rushabhcodes/desk-fidget-counter/__snapshots__/index.circuit-3d.snap.png

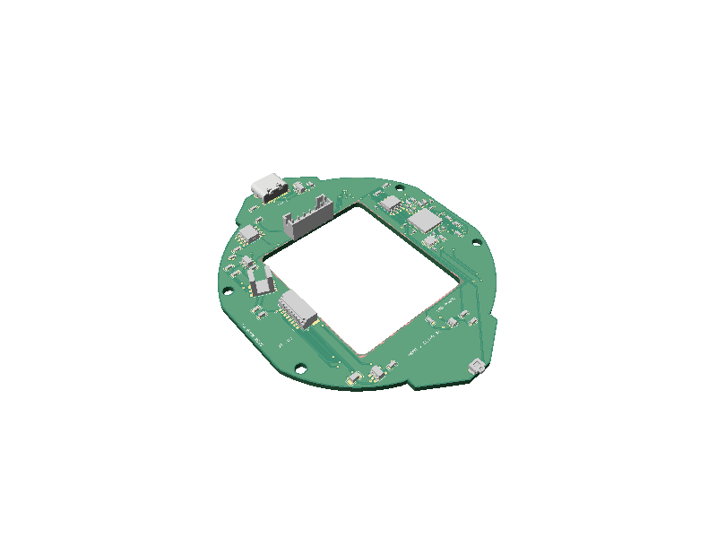
__snapshots__/index.circuit-3d.snap.png
