rushabhcodes/desk-fidget-counter/dist/index/pcb.png

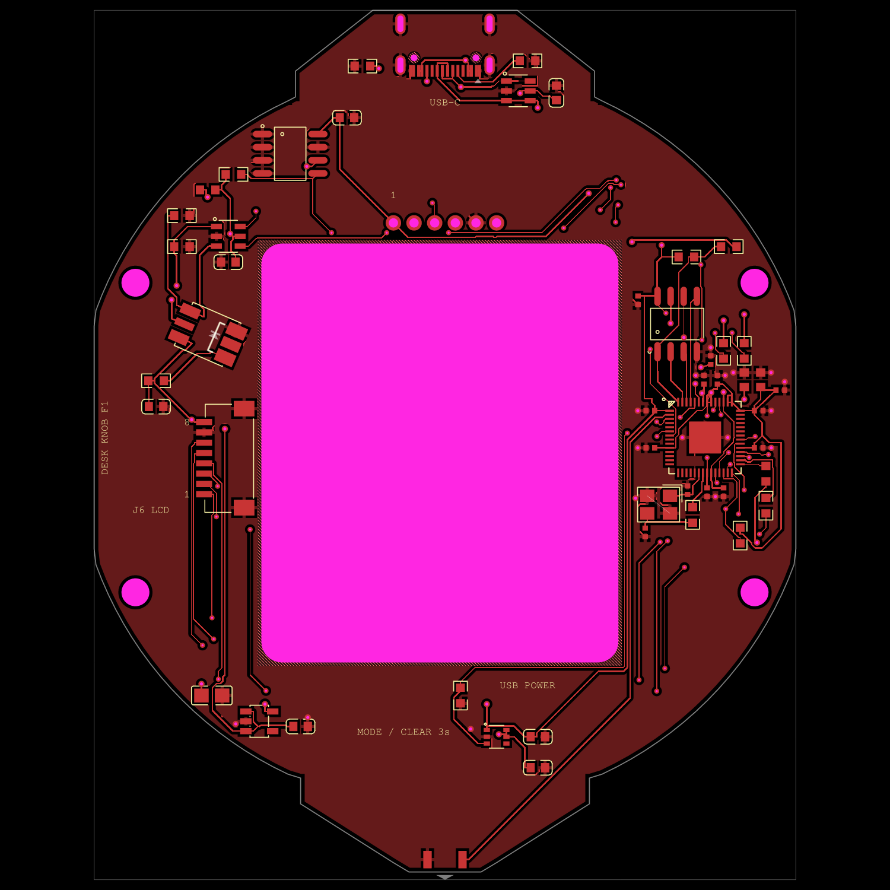
dist/index/pcb.png
