rushabhcodes/desk-fidget-counter/dist/index/schematic.png

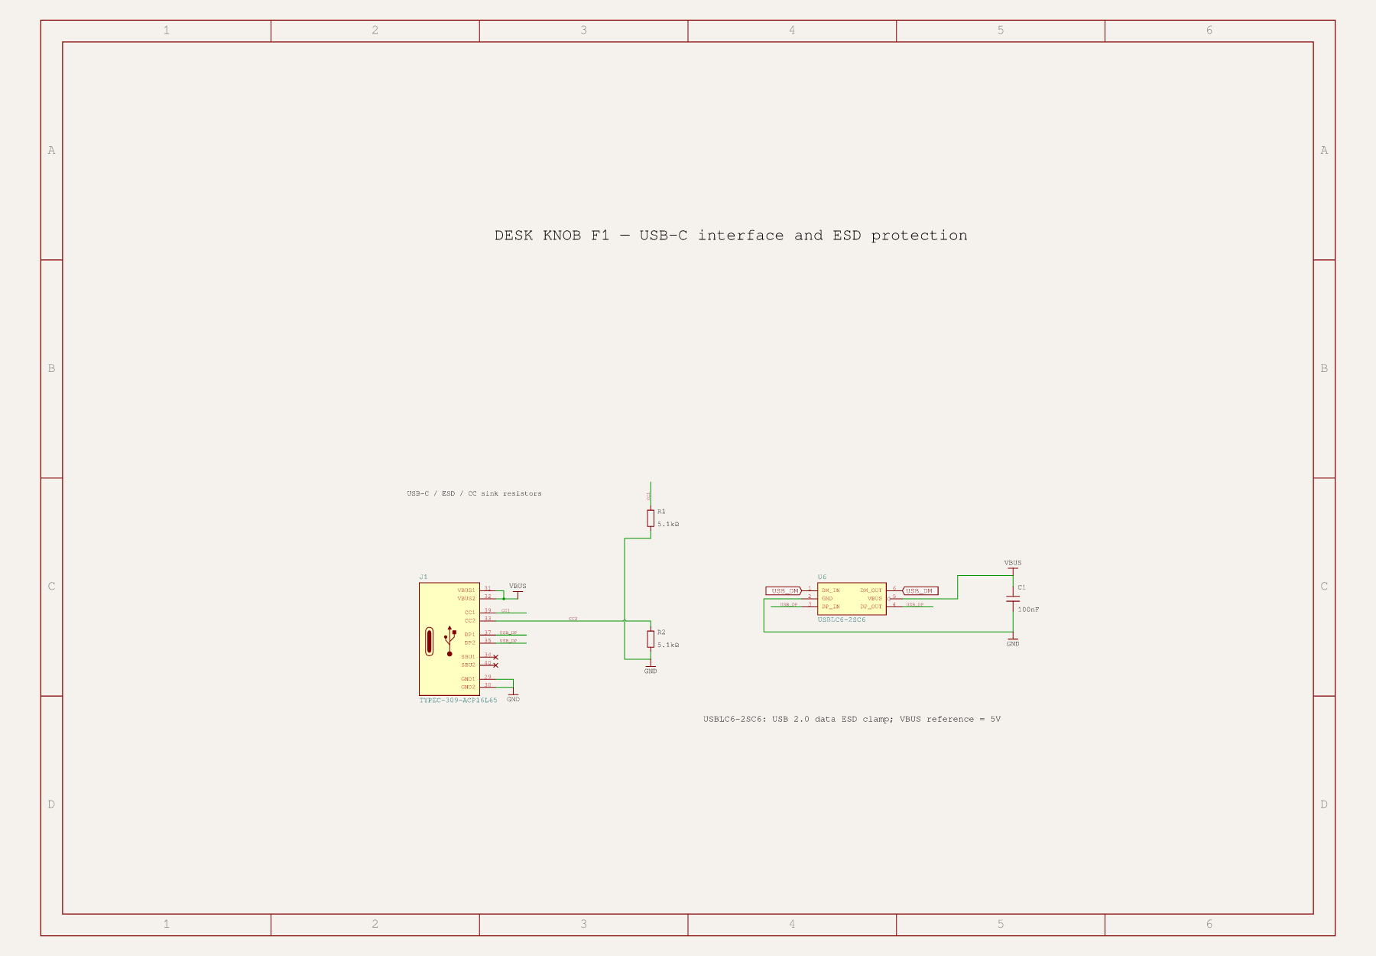
dist/index/schematic.png
