rushabhcodes/desk-fidget-counter/manufacturing/current/assembly/schematic-2-usb-power-and-switched-peripherals.png

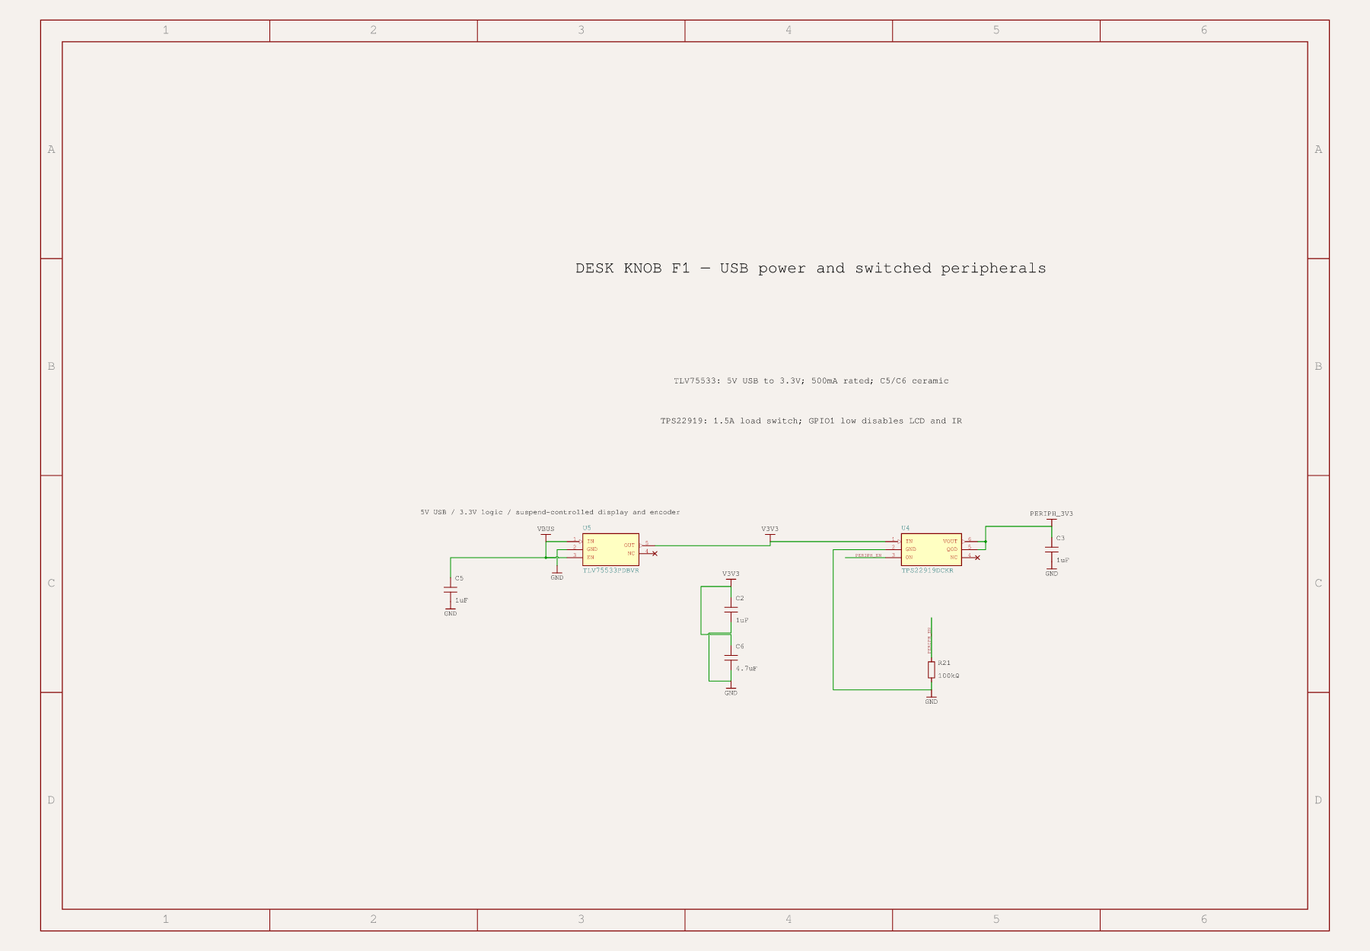
manufacturing/current/assembly/schematic-2-usb-power-and-switched-peripherals.png
