rushabhcodes/desk-fidget-counter/manufacturing/current/assembly/schematic-3-rp2040-power-controls-and-programming.png

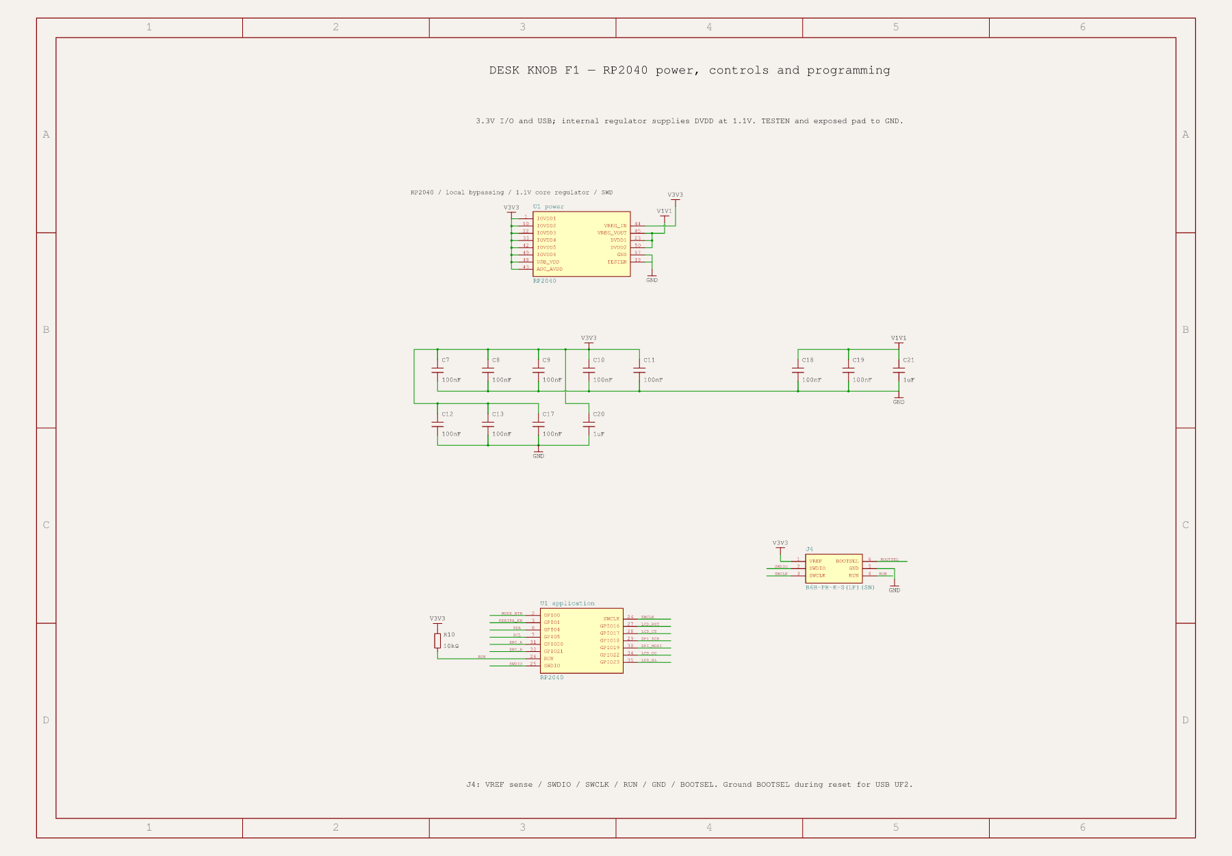
manufacturing/current/assembly/schematic-3-rp2040-power-controls-and-programming.png
