rushabhcodes/desk-fidget-counter/manufacturing/current/assembly/schematic-4-optical-rotation-encoder.png

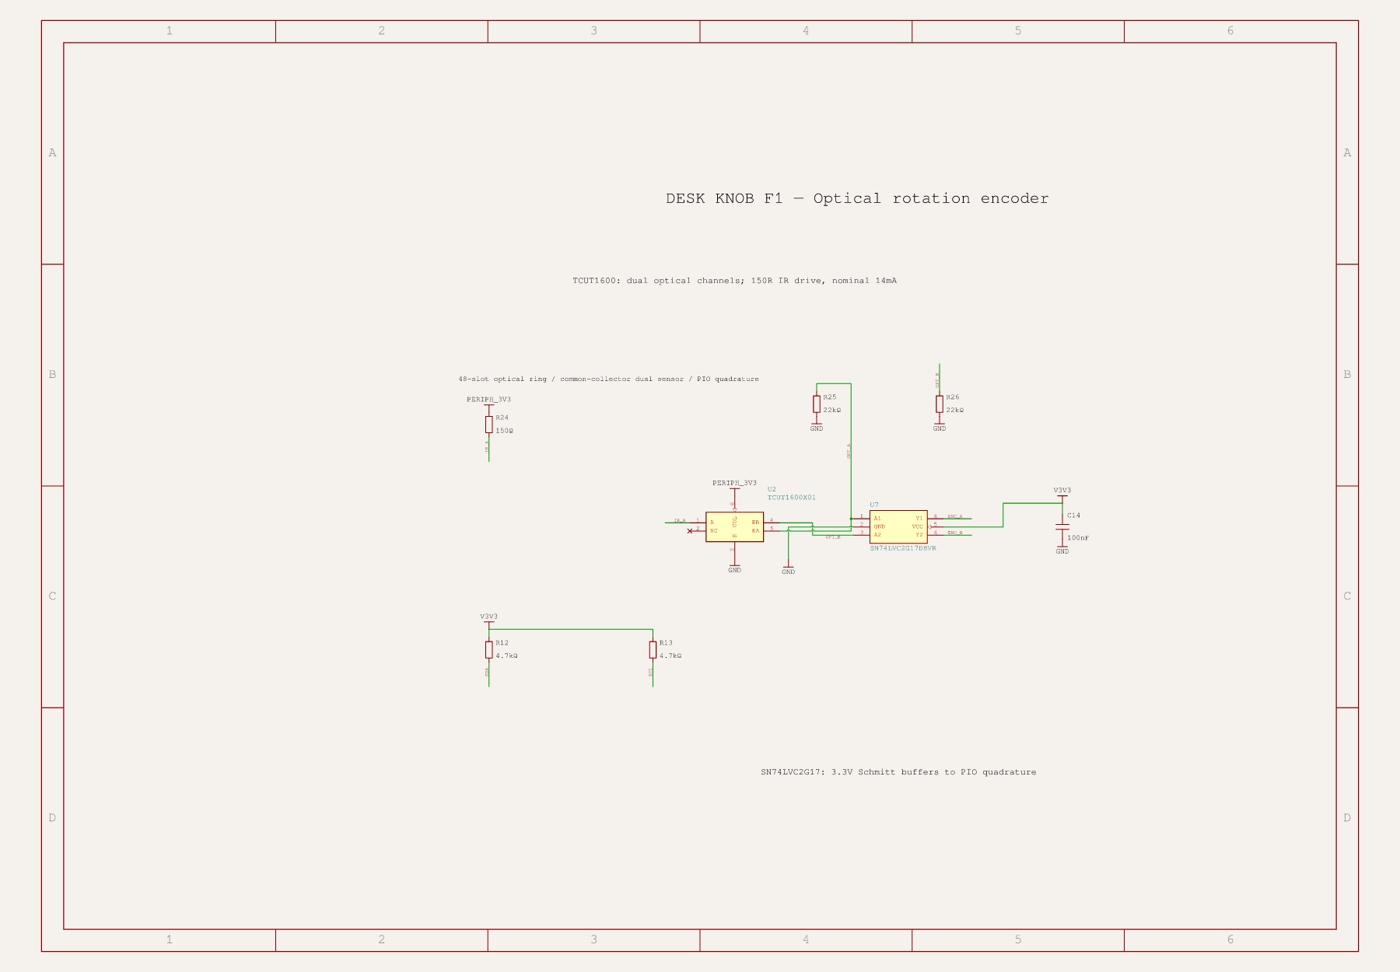
manufacturing/current/assembly/schematic-4-optical-rotation-encoder.png
