rushabhcodes/desk-fidget-counter/manufacturing/current/assembly/schematic-5-persistent-turn-storage.png

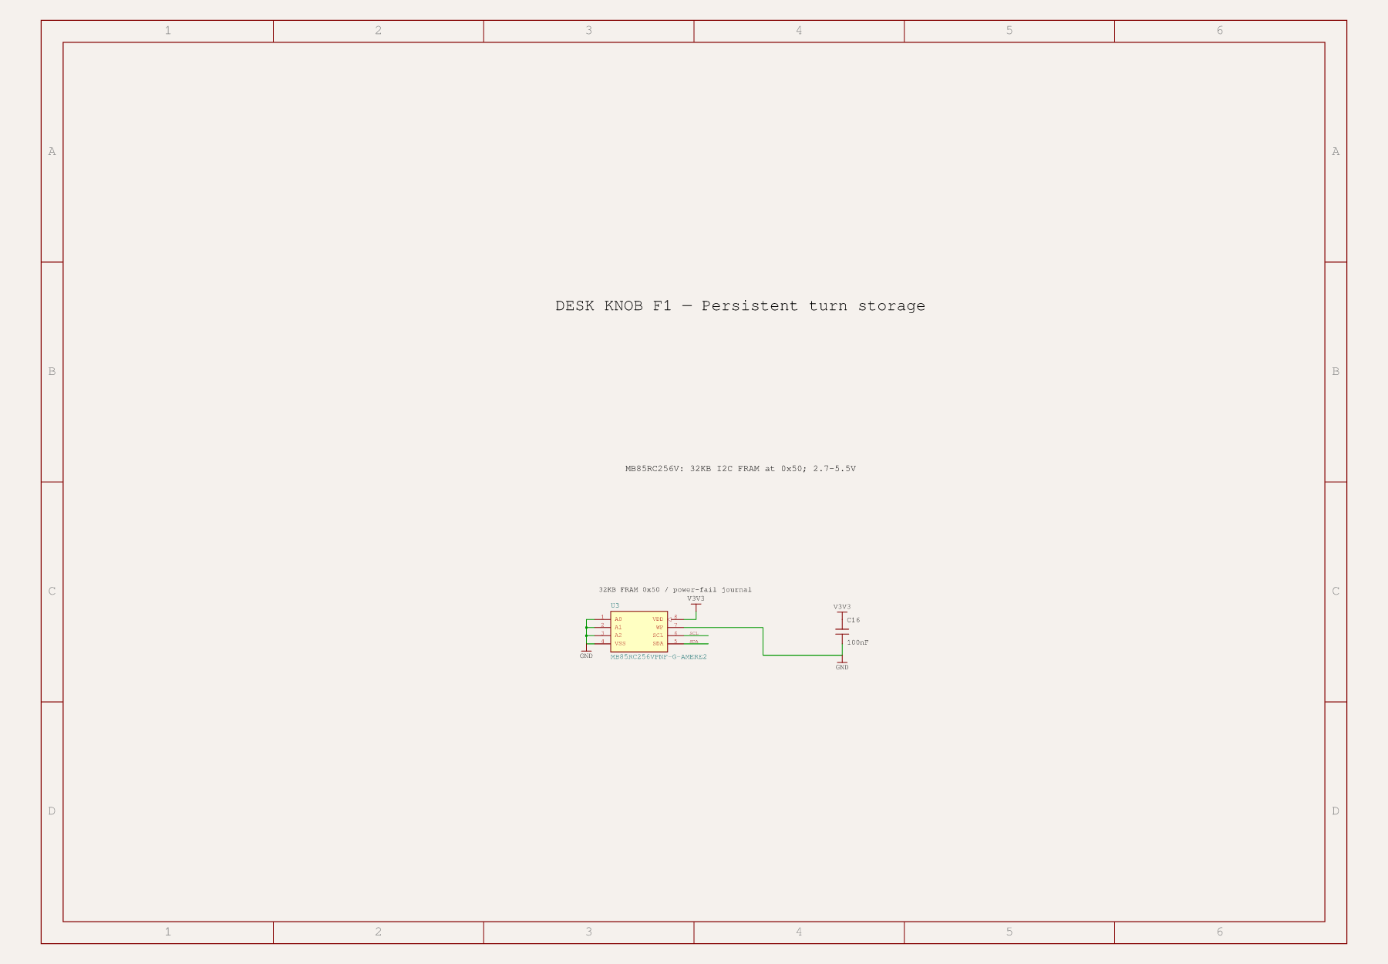
manufacturing/current/assembly/schematic-5-persistent-turn-storage.png
