rushabhcodes/desk-fidget-counter/manufacturing/current/assembly/schematic-6-user-controls-and-status.png

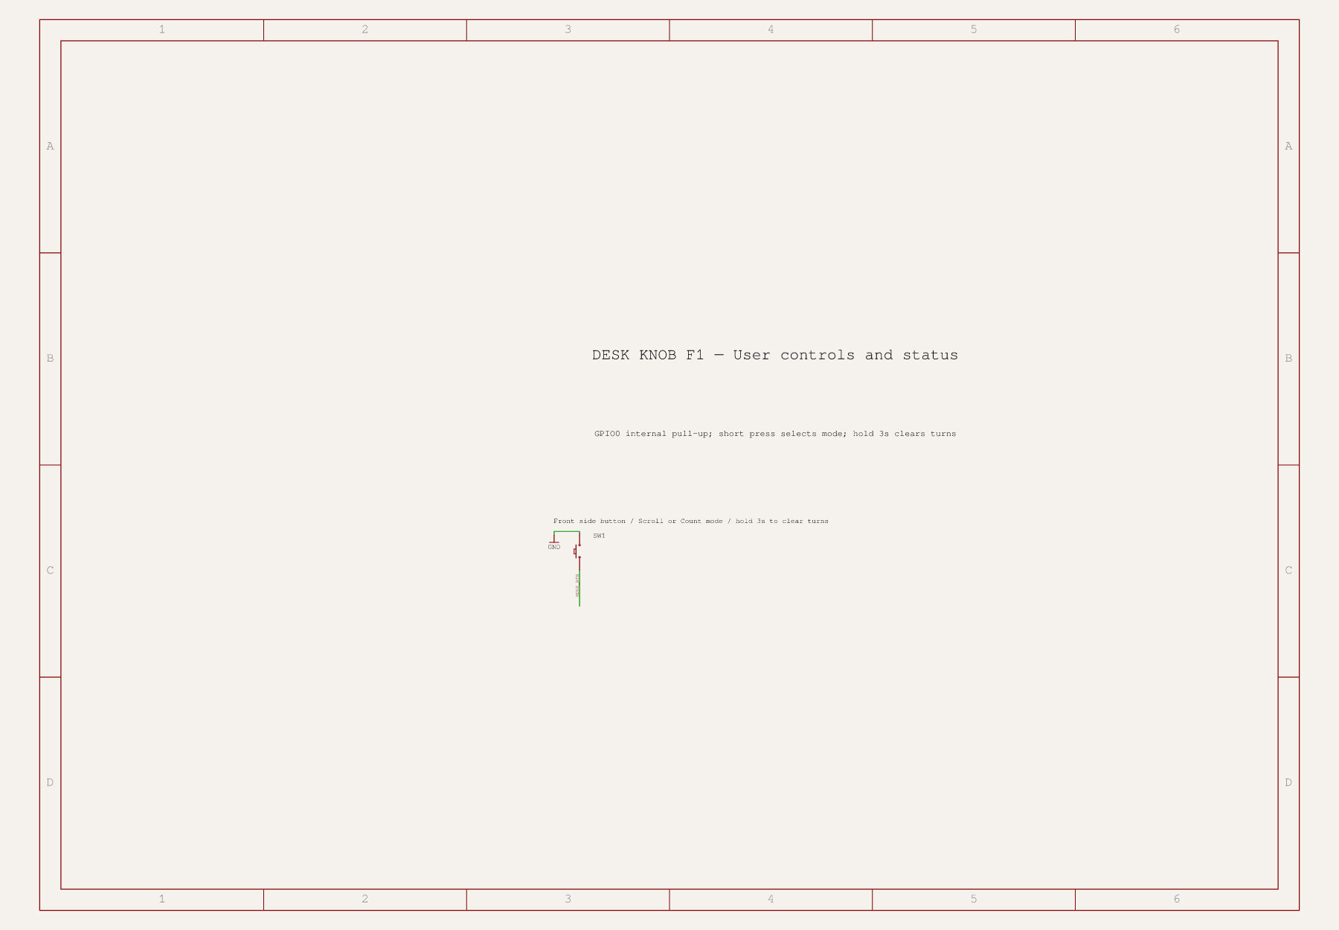
manufacturing/current/assembly/schematic-6-user-controls-and-status.png
