rushabhcodes/desk-fidget-counter/manufacturing/current/assembly/schematic-7-round-display-and-laptop-dashboard.png

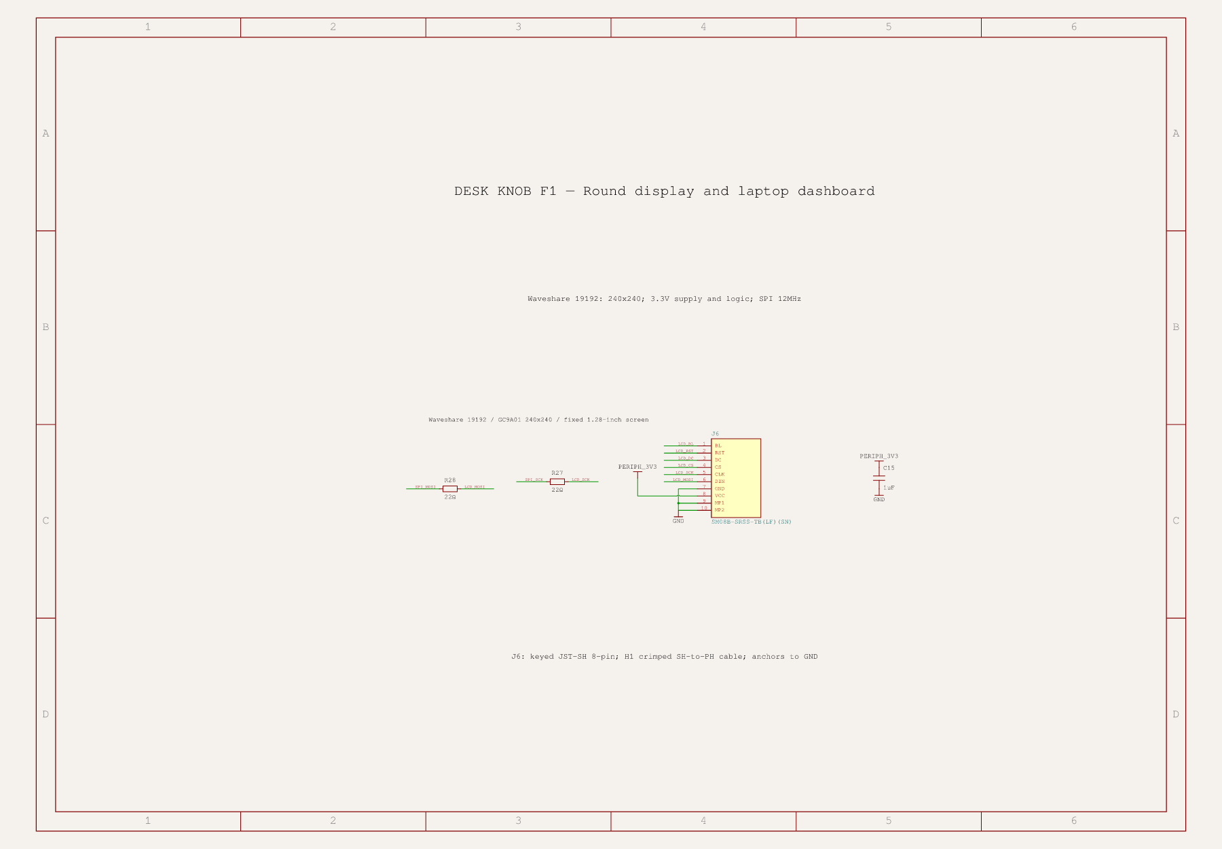
manufacturing/current/assembly/schematic-7-round-display-and-laptop-dashboard.png
