rushabhcodes/desk-fidget-counter/manufacturing/current/assembly/schematic-8-rp2040-boot-flash-clock-and-usb-termination.png

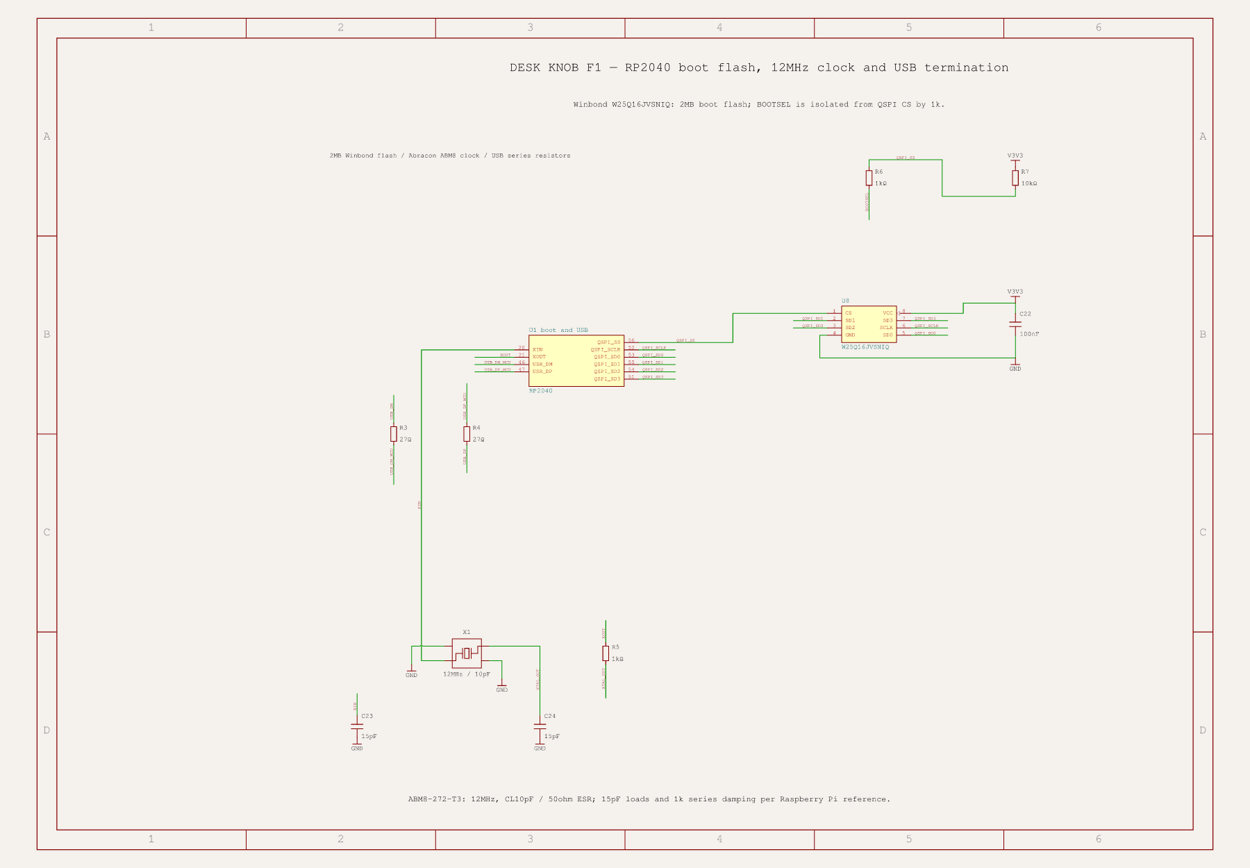
manufacturing/current/assembly/schematic-8-rp2040-boot-flash-clock-and-usb-termination.png
