rushabhcodes/desk-fidget-counter/mechanical/bearing-detail.png

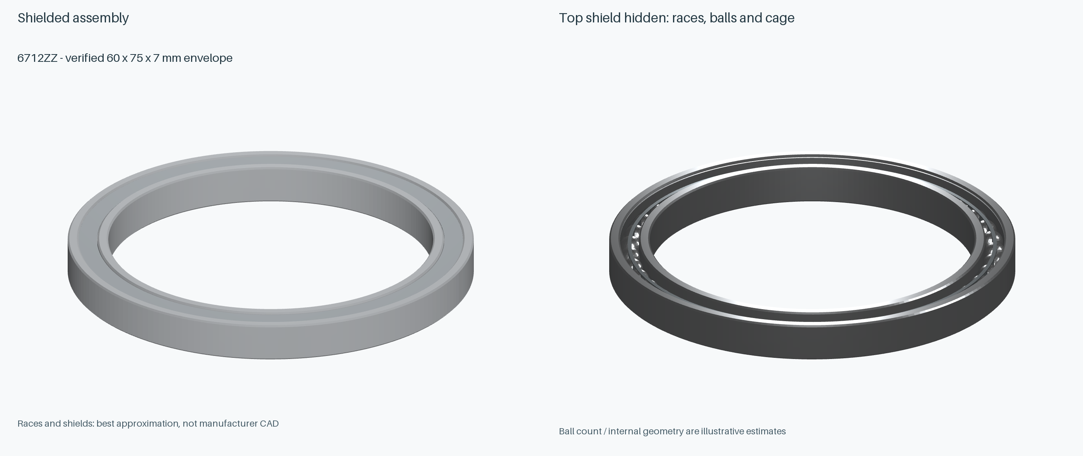
mechanical/bearing-detail.png
