rushabhcodes/desk-fidget-counter/mechanical/bearing-envelope.png

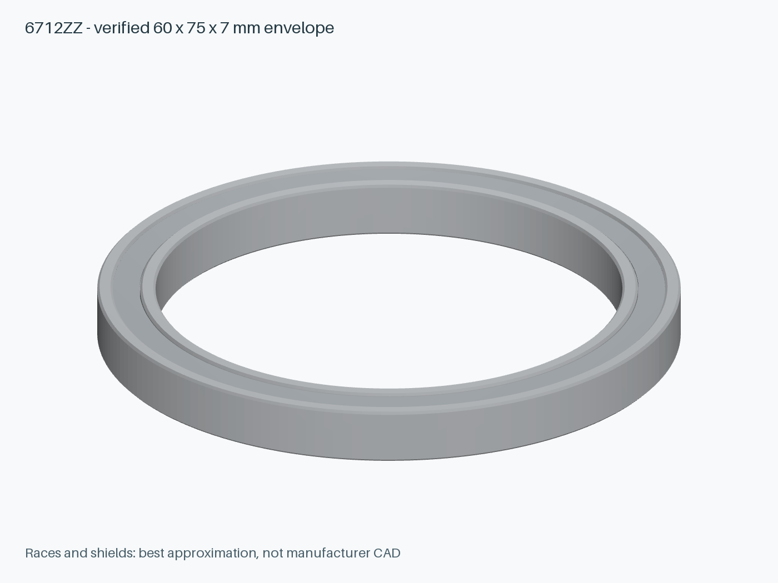
mechanical/bearing-envelope.png
