rushabhcodes/desk-fidget-counter/mechanical/button-access.png

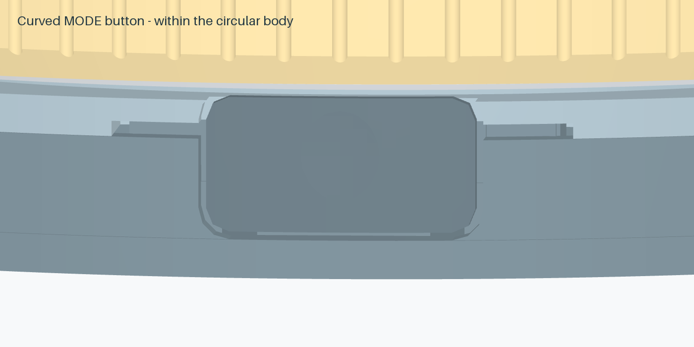
mechanical/button-access.png
