rushabhcodes/desk-fidget-counter/mechanical/button-internal.png

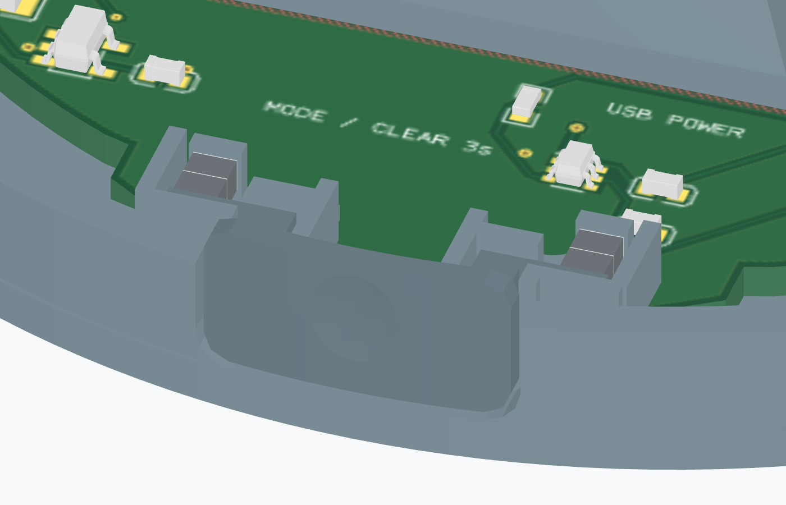
mechanical/button-internal.png
