rushabhcodes/desk-fidget-counter/mechanical/classic-service/previews/comparison.png

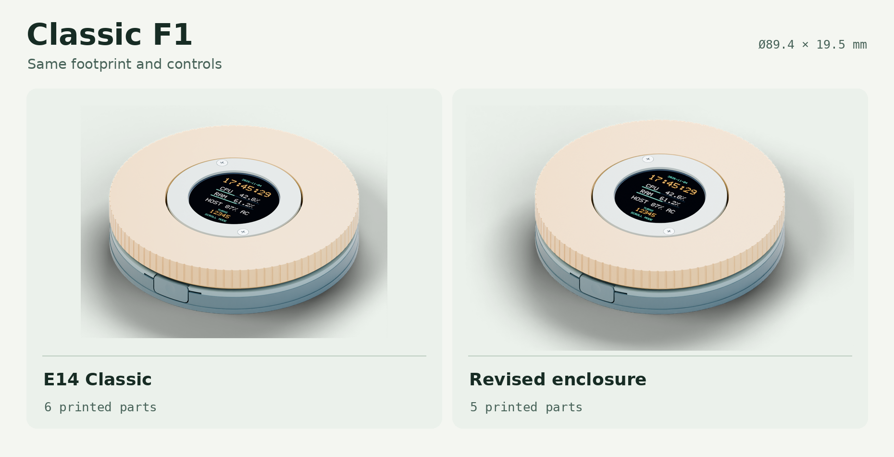
mechanical/classic-service/previews/comparison.png
