rushabhcodes/desk-fidget-counter/mechanical/exploded.png

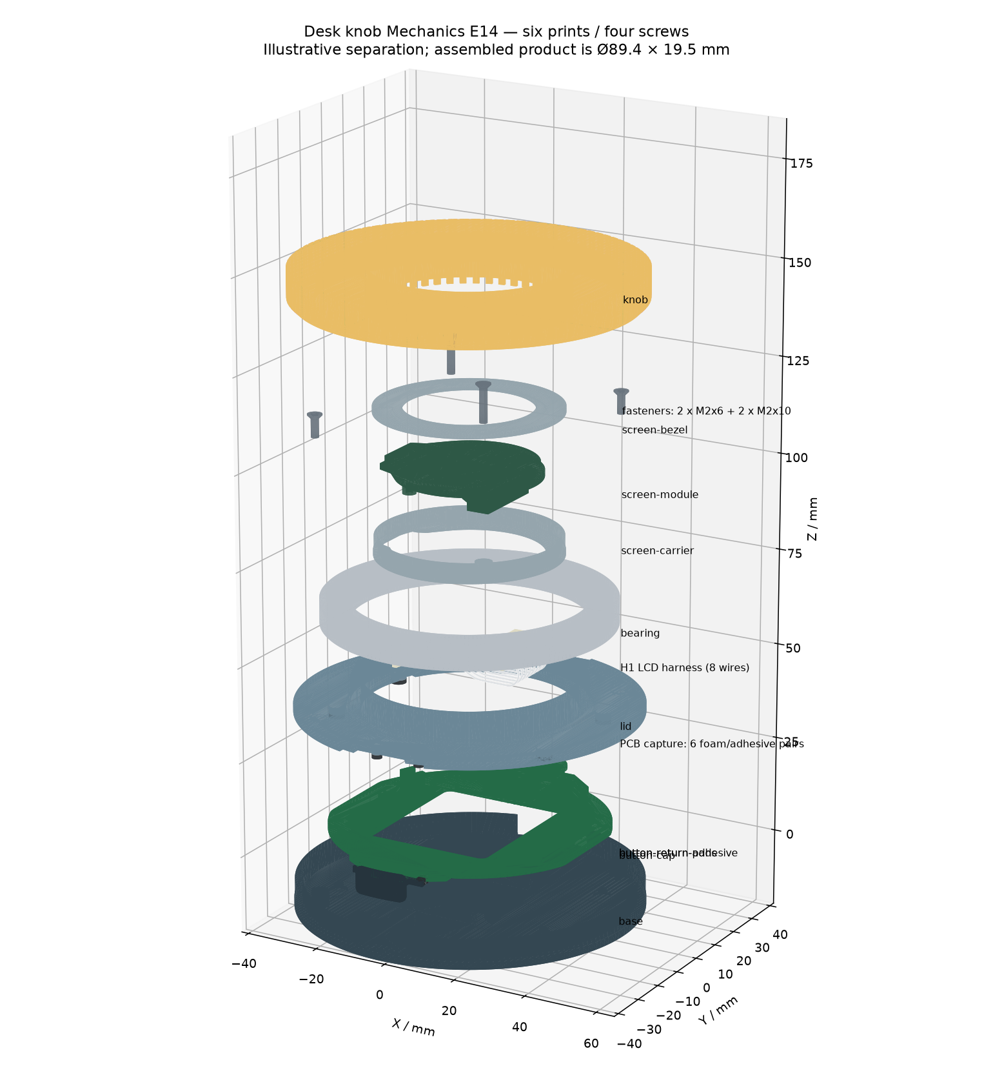
mechanical/exploded.png
