rushabhcodes/desk-fidget-counter/mechanical/height-comparison.png

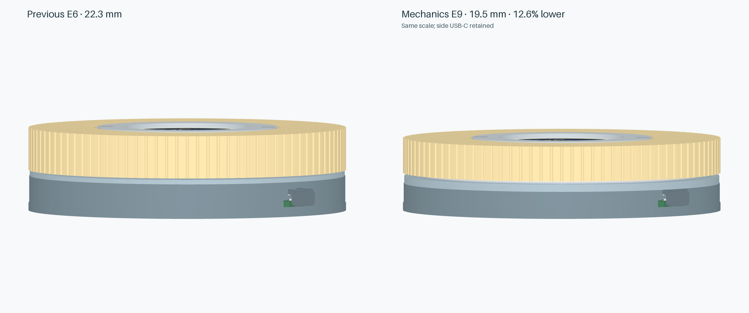
mechanical/height-comparison.png
