rushabhcodes/desk-fidget-counter/mechanical/review/current-v6.0.1.jpg

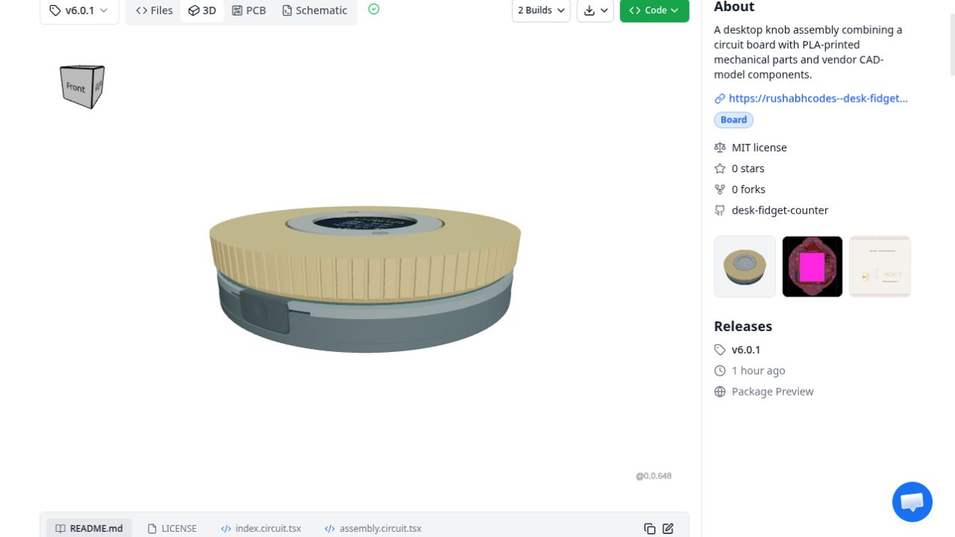
mechanical/review/current-v6.0.1.jpg
