rushabhcodes/desk-fidget-counter/mechanical/screen-connector.png

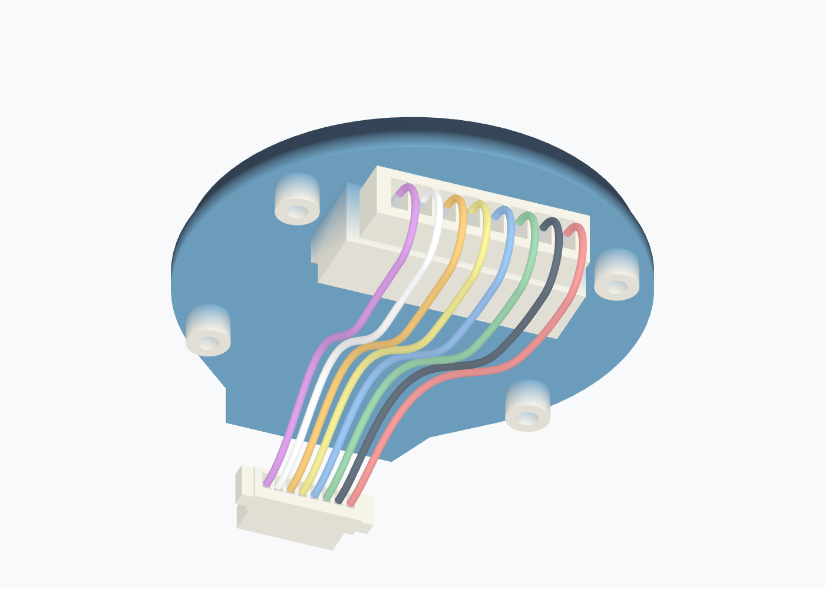
mechanical/screen-connector.png
