rushabhcodes/desk-fidget-counter/mechanical/side-profile.png

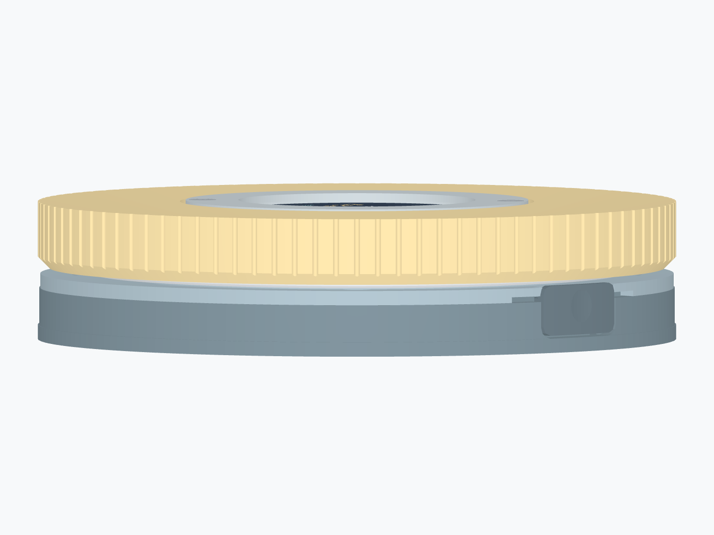
mechanical/side-profile.png
