rushabhcodes/desk-fidget-counter/mechanical/usb-access-comparison.png

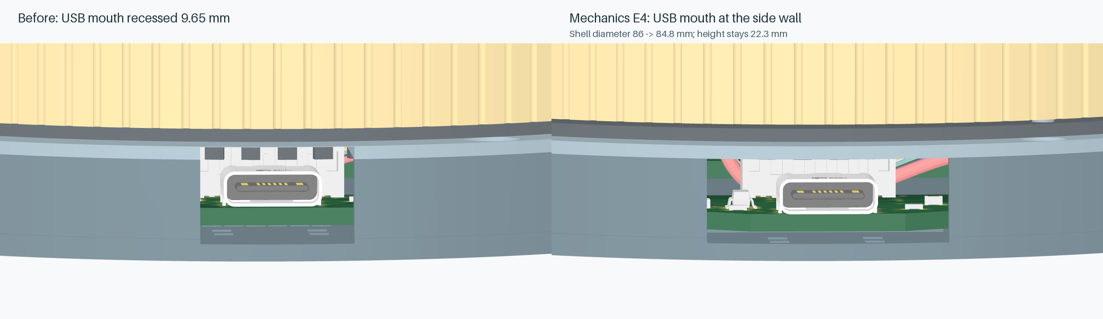
mechanical/usb-access-comparison.png
