rushabhcodes/desk-fidget-counter/mechanical/usb-access.png

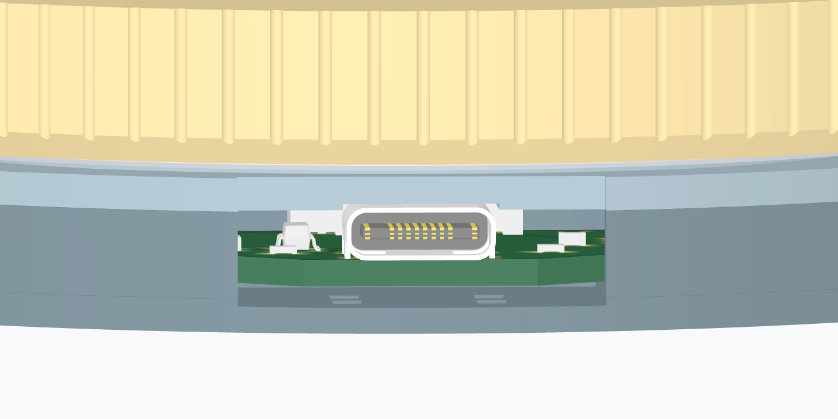
mechanical/usb-access.png
