rushabhcodes/desk-fidget-counter/previews/gerber-bottom.png

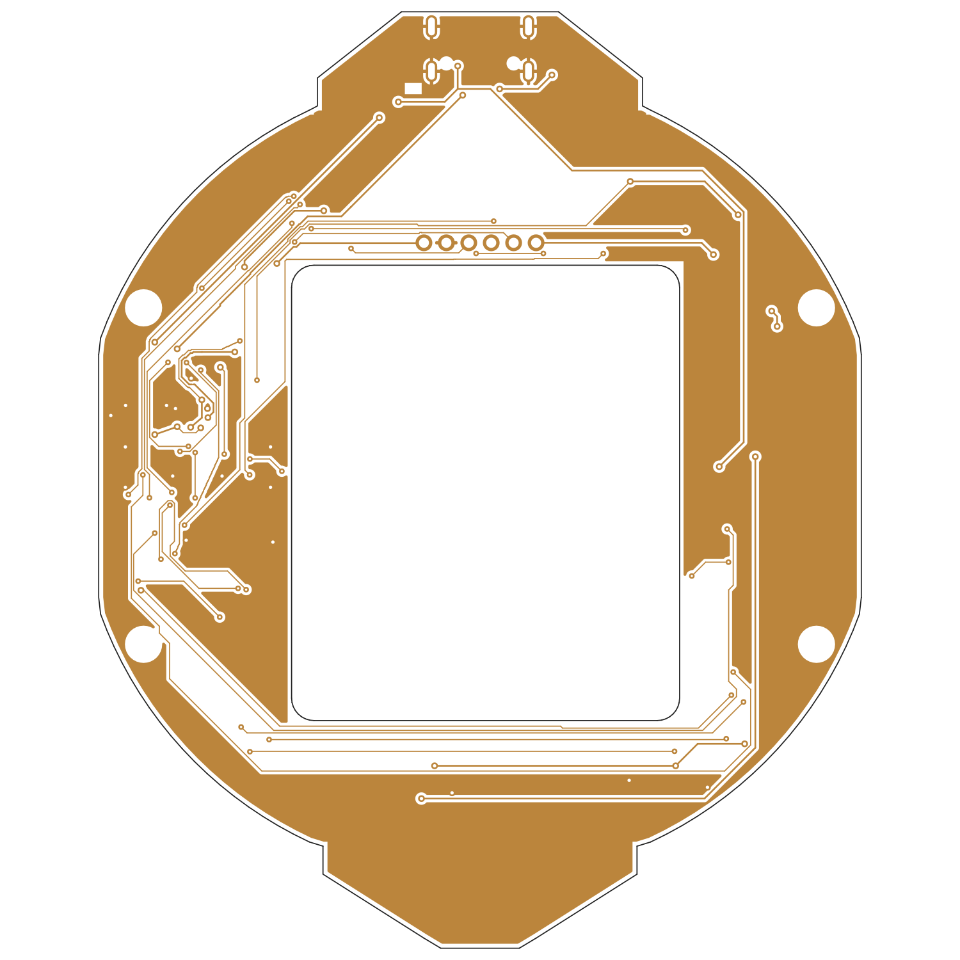
previews/gerber-bottom.png
