rushabhcodes/desk-fidget-counter/previews/gerber-top.png

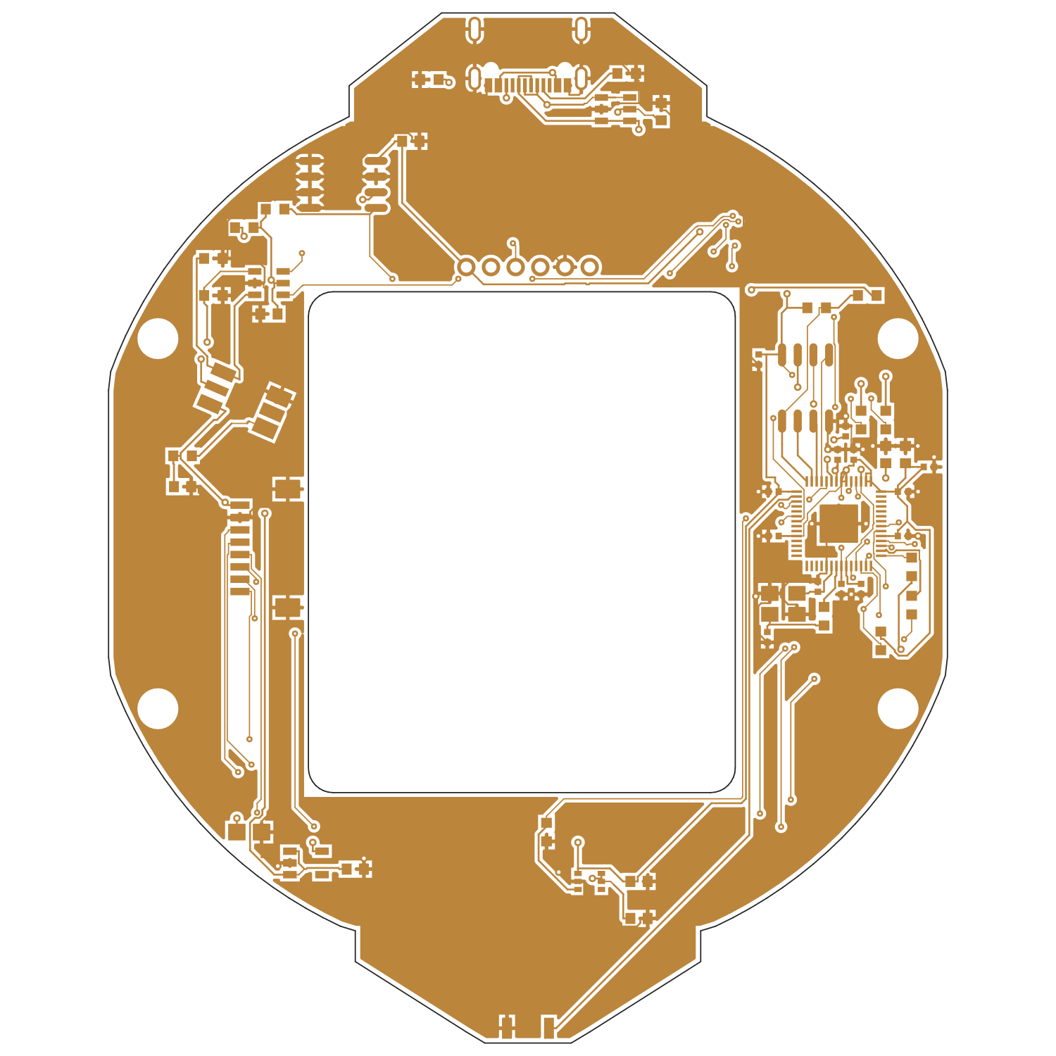
previews/gerber-top.png
