rushabhcodes/desk-fidget-counter/previews/pcb-bottom.png

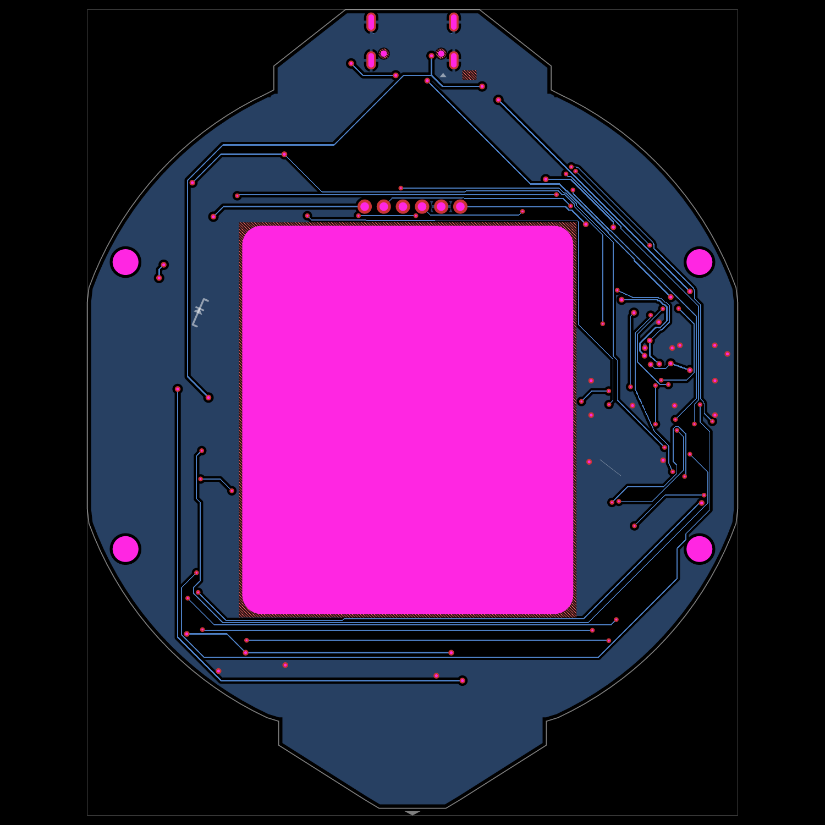
previews/pcb-bottom.png
