rushabhcodes/desk-fidget-counter/previews/screen-ui.png

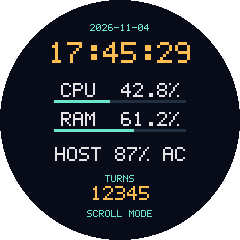
previews/screen-ui.png
