rushabhcodes/desk-fidget-counter/manufacturing/current/BOM-complete.csv

Comment | Designator | Footprint | LCSC Part # | Manufacturer | MPN
GRM188R71C104KA01D / 100nF 16V X7R 10% | C1,C14,C16 | 0603 | C45000 | Murata Electronics | GRM188R71C104KA01D
GRM188R61A105KA61D / 1uF 10V X5R 10% | C2,C3,C5,C15,C20,C21 | 0603 | C86012 | Murata Electronics | GRM188R61A105KA61D
CL21A475KOFNNNE / 4.7uF 16V X5R 10% | C6 | 0805 | C1746 | Samsung Electro-Mechanics | CL21A475KOFNNNE
GRM155R71C104KA88D / 100nF 16V X7R 10% | C7,C8,C9,C10,C11,C12,C13,C17,C18,C19,C22 | 0402 | C71629 | Murata Electronics | GRM155R71C104KA88D
0402CG150J500NT / 15pF 50V C0G 5% crystal load | C23,C24 | 0402 | C1548 | FH (Guangdong Fenghua Advanced Tech) | 0402CG150J500NT
TYPEC-309-ACP16L65 / USB-C receptacle, 6.5mm body, 3A/5V per drawing; USB 2.0 D+/D- and CC contacts | J1 | SMD, 16 contacts / 4 shell stakes | C2909598 | XUNPU | TYPEC-309-ACP16L65
B6B-PH-K-S(LF)(SN) / 6-pin top-entry programming header | J4 | JST-PH-6-P2.0-THT | C131342 | JST | B6B-PH-K-S(LF)(SN)
SM08B-SRSS-TB(LF)(SN) / Keyed 8-pin side-entry SMT display socket; two grounded hold-downs | J6 | JST-SH-8-P1.0-SMT-side-entry | C160407 | JST | SM08B-SRSS-TB(LF)(SN)
RC0603FR-075K1L / 5.1k 1% 100mW | R1,R2 | 0603 | C105580 | YAGEO | RC0603FR-075K1L
0603WAF270JT5E / 27ohm 1% USB series termination | R3,R4 | 0603 | C25190 | UNI-ROYAL(Uniroyal Elec) | 0603WAF270JT5E
0603WAF1001T5E / 1kohm 1% clock damping / BOOTSEL isolation | R5,R6 | 0603 | C21190 | UNI-ROYAL(Uniroyal Elec) | 0603WAF1001T5E
RC0603FR-0710KL / 10k 1% 100mW | R7,R10 | 0603 | C98220 | YAGEO | RC0603FR-0710KL
RC0603FR-074K7L / 4.7k 1% 100mW | R12,R13 | 0603 | C99782 | YAGEO | RC0603FR-074K7L
RC0603FR-07100KL / 100k 1% 100mW | R21 | 0603 | C14675 | YAGEO | RC0603FR-07100KL
RC0603FR-07150RL / 150R 1% 100mW | R24 | 0603 | C114608 | YAGEO | RC0603FR-07150RL
RC0603FR-0722KL / 22k 1% 100mW | R25,R26 | 0603 | C114065 | YAGEO | RC0603FR-0722KL
RC0603FR-0722RL / 22R 1% 100mW | R27,R28 | 0603 | C107701 | YAGEO | RC0603FR-0722RL
B3U-3000P / side-actuated SMT switch | SW1 | Omron-B3U-3000P | C963349 | Omron Electronics | B3U-3000P
RP2040 / Dual Cortex-M0+ MCU; external boot flash | U1 | QFN-56-EP7x7-P0.4 | C2040 | Raspberry Pi | RP2040
TCUT1600X01 / dual optical interrupter 3mm slot | U2 | Vishay-TCUT1600-SMD-6 | C511085 | Vishay Intertech | TCUT1600X01
MB85RC256VPNF-G-AMERE2 / 256kbit I2C FRAM | U3 | SOP-8-150mil | C45273903 | RAMXEED/FUJITSU | MB85RC256VPNF-G-AMERE2
TPS22919DCKR / load switch | U4 | SC70-6 | C2149796 | Texas Instruments | TPS22919DCKR
TLV75533PDBVR / 3.3V LDO | U5 | SOT-23-5 | C404027 | Texas Instruments | TLV75533PDBVR
USBLC6-2SC6 / ST USB ESD array | U6 | SOT-23-6 | C7519 | STMicroelectronics | USBLC6-2SC6
SN74LVC2G17DBVR / TI dual Schmitt buffer | U7 | SOT-23-6 | C10429 | Texas Instruments | SN74LVC2G17DBVR
W25Q16JVSNIQ / Winbond 16Mbit/2MB 3.3V QSPI NOR flash | U8 | SOIC-8-150mil | C2456211 | Winbond Elec | W25Q16JVSNIQ
ABM8-272-T3 / Abracon 12MHz, CL10pF, 50ohm ESR crystal | X1 | SMD-3225-4P | C20625731 | Abracon LLC | ABM8-272-T3
