rushabhcodes/desk-fidget-counter/imports/jlc/A_61300821021/A_61300821021.step

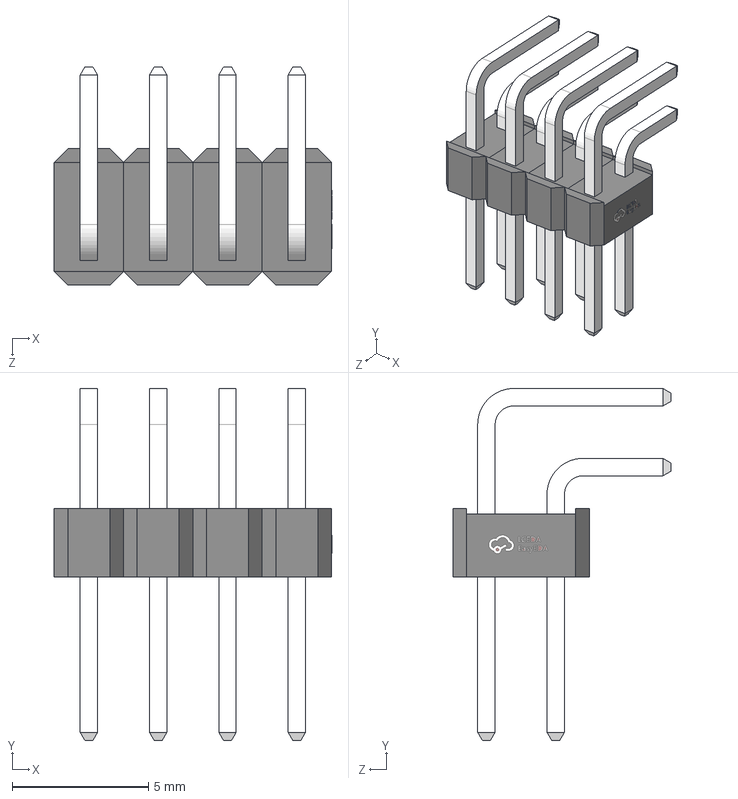
[picture p38: CAD file, 2026-11-09]
imports/jlc/A_61300821021/A_61300821021.step
10.2 x 12.9 x 8.00 mm
