rushabhcodes/desk-fidget-counter/imports/jlc/SM08B_SRSS_TB_LF__SN_/SM08B_SRSS_TB_LF__SN_.step

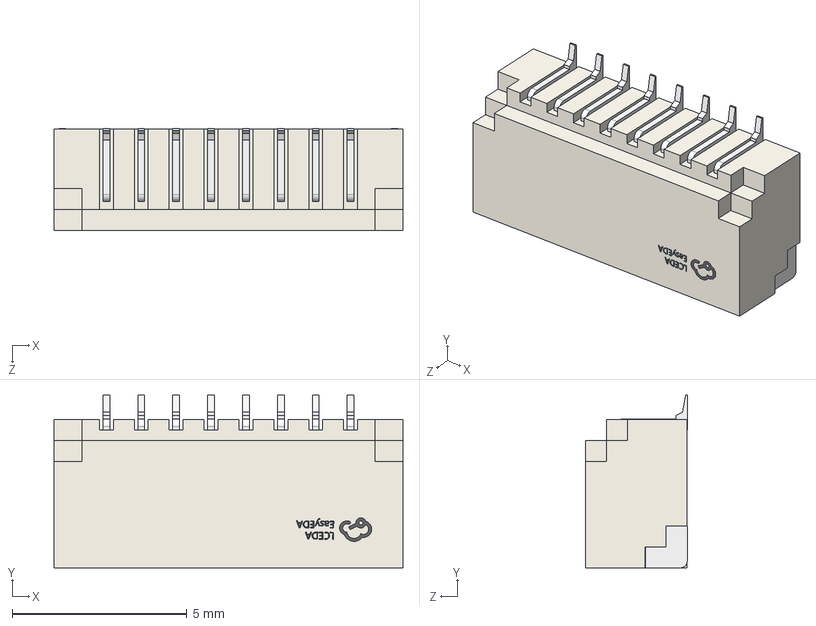
[picture p39: CAD file, 2026-11-09]
imports/jlc/SM08B_SRSS_TB_LF__SN_/SM08B_SRSS_TB_LF__SN_.step
10.0 x 4.95 x 2.91 mm
