rushabhcodes/desk-fidget-counter/imports/jlc/TYPEC_309_ACP16L65/TYPEC_309_ACP16L65.step

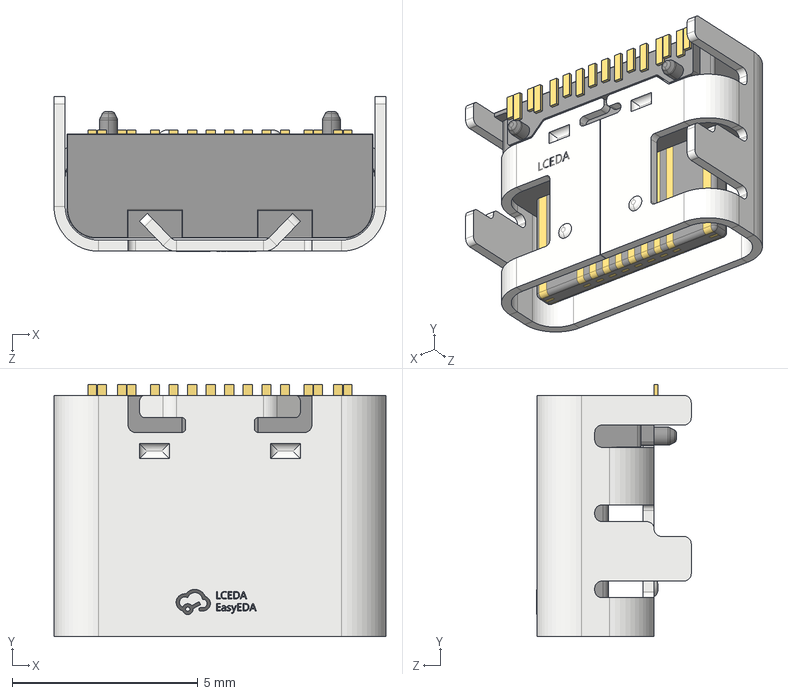
[picture p40: CAD file, 2026-11-09]
imports/jlc/TYPEC_309_ACP16L65/TYPEC_309_ACP16L65.step
8.94 x 6.80 x 4.16 mm
