rushabhcodes/desk-fidget-counter/manufacturing/current/enclosure/stl/screen-carrier.stl

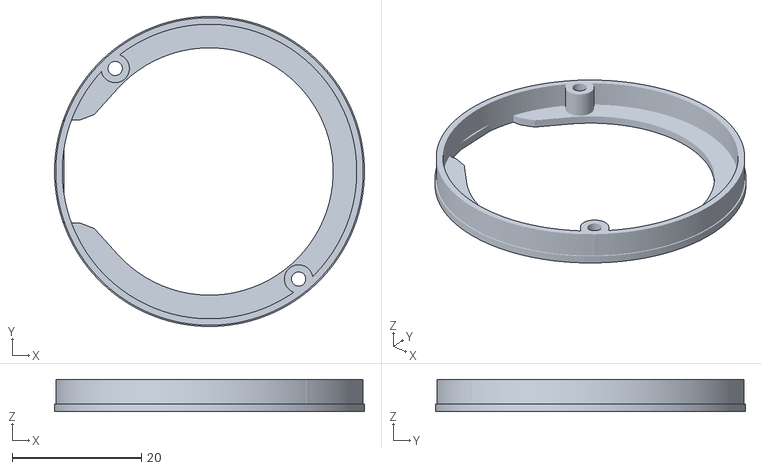
[picture p41: CAD file, 2026-11-10]
manufacturing/current/enclosure/stl/screen-carrier.stl
48.0 x 48.0 x 5.00
