rushabhcodes/desk-fidget-counter/mechanical/cad/button-return-adhesive.obj

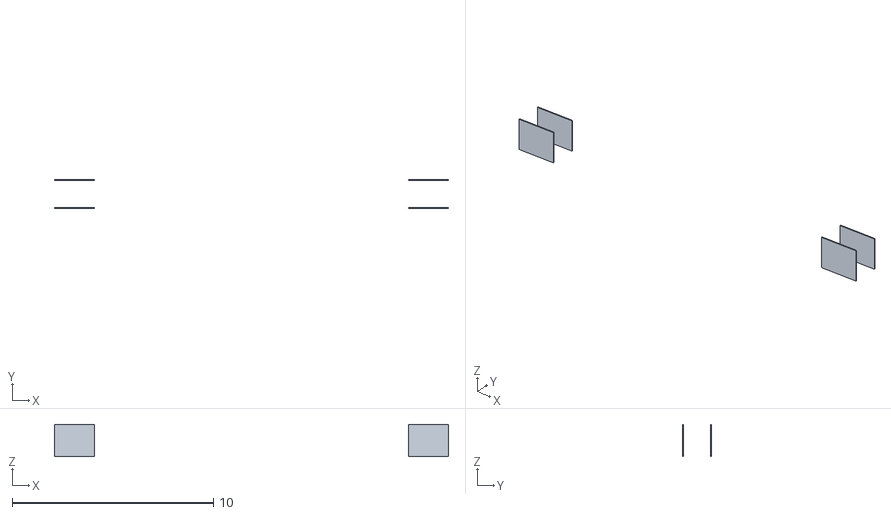
[picture p42: CAD file, 2026-11-10]
mechanical/cad/button-return-adhesive.obj
19.6 x 1.43 x 1.60
