rushabhcodes/desk-fidget-counter/manufacturing/current/enclosure/stl/button-cap.stl

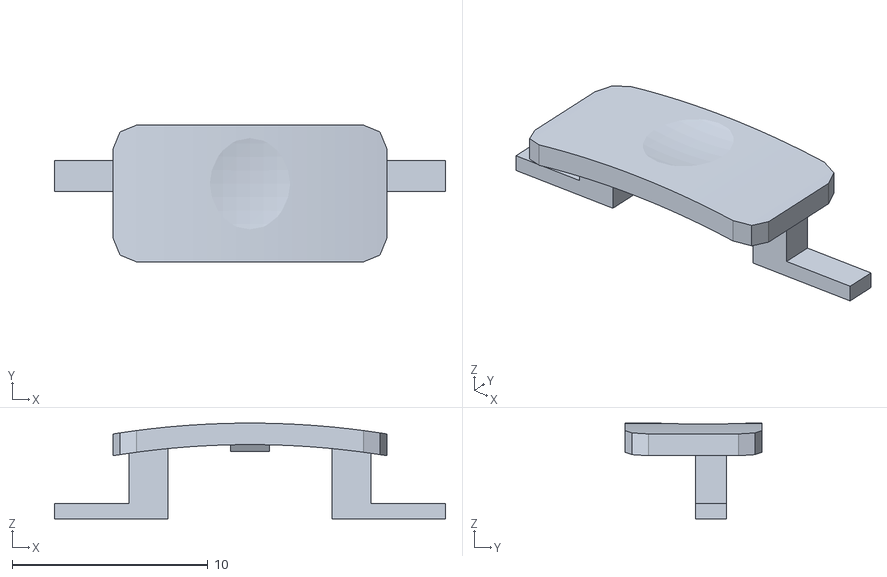
[picture p43: CAD file, 2026-11-10]
manufacturing/current/enclosure/stl/button-cap.stl
20.0 x 7.00 x 4.90
