rushabhcodes/desk-fidget-counter/mechanical/cad/button-return-pads.obj

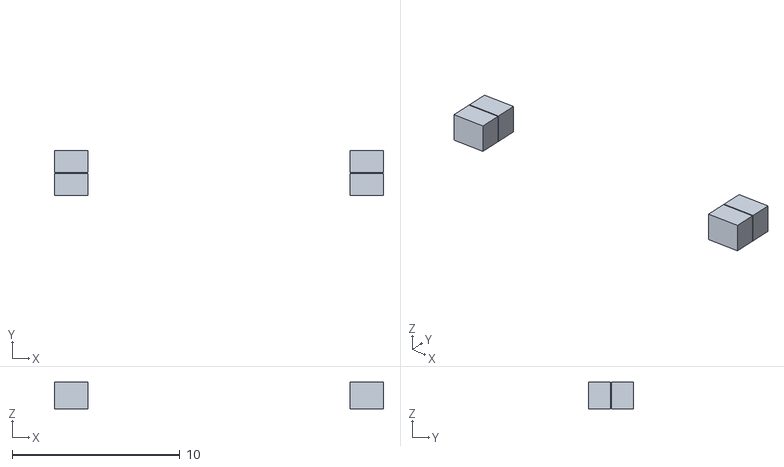
[picture p44: CAD file, 2026-11-10]
mechanical/cad/button-return-pads.obj
19.6 x 2.70 x 1.60
