rushabhcodes/desk-fidget-counter/mechanical/stl/knob.stl

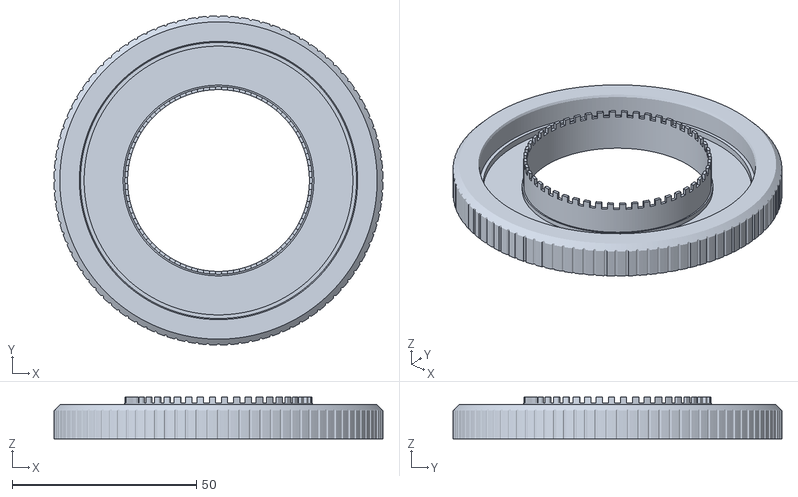
[picture p45: CAD file, 2026-11-10]
mechanical/stl/knob.stl
89.4 x 89.4 x 11.4
