rushabhcodes/desk-fidget-counter/manufacturing/current/enclosure/stl/lid.stl

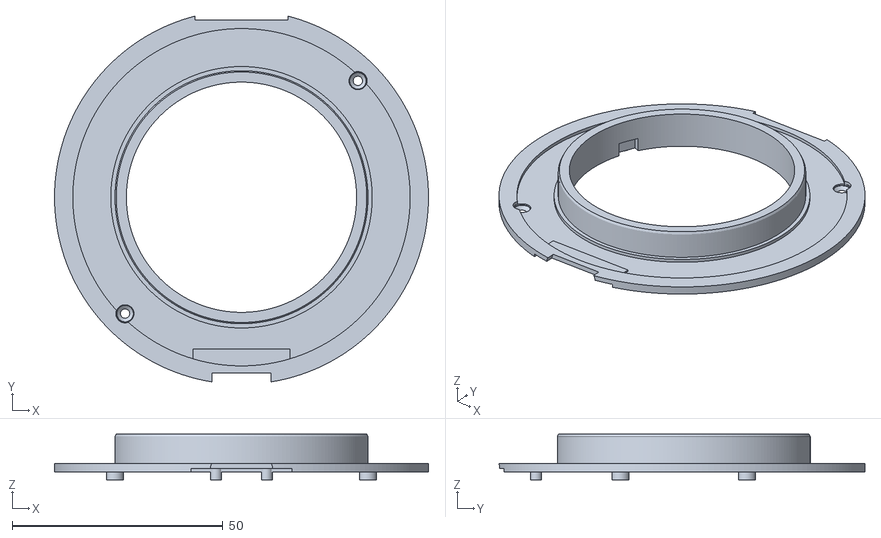
[picture p46: CAD file, 2026-11-10]
manufacturing/current/enclosure/stl/lid.stl
88.7 x 86.8 x 10.9
