rushabhcodes/desk-fidget-counter/mechanical/cad/lcd-cable-contacts.obj

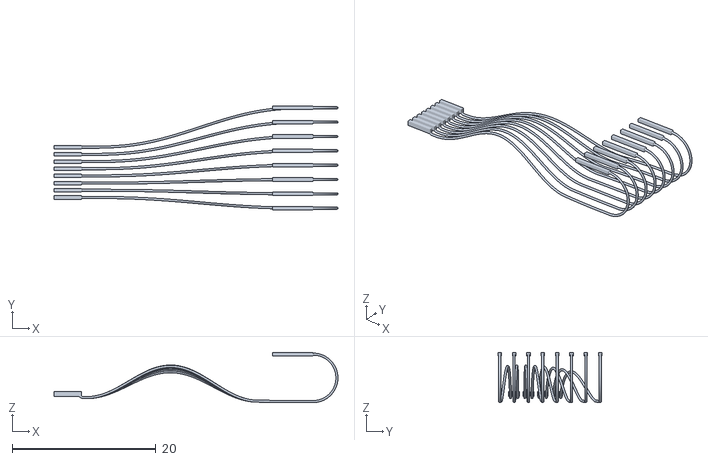
[picture p47: CAD file, 2026-11-09]
mechanical/cad/lcd-cable-contacts.obj
39.6 x 14.5 x 7.00
