rushabhcodes/desk-fidget-counter/manufacturing/current/enclosure/stl/base.stl

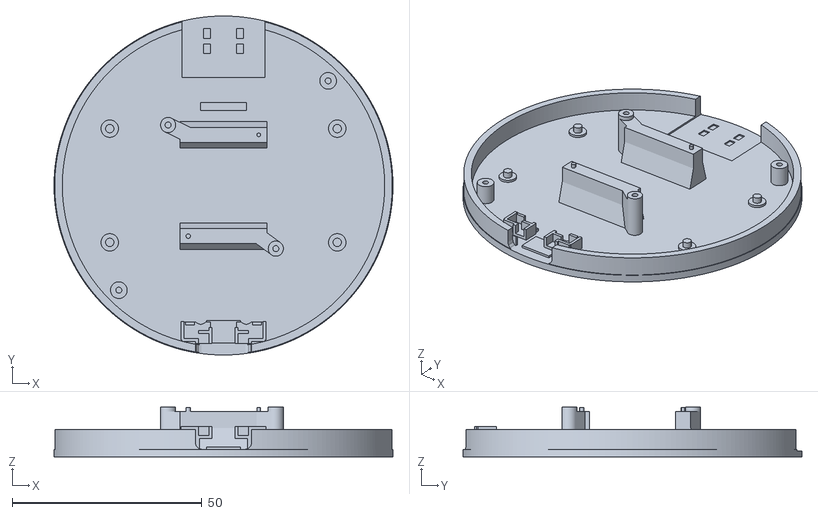
[picture p48: CAD file, 2026-11-10]
manufacturing/current/enclosure/stl/base.stl
89.4 x 89.4 x 13.1
