rushabhcodes/desk-fidget-counter/mechanical/cad/lcd-wire-bl.obj

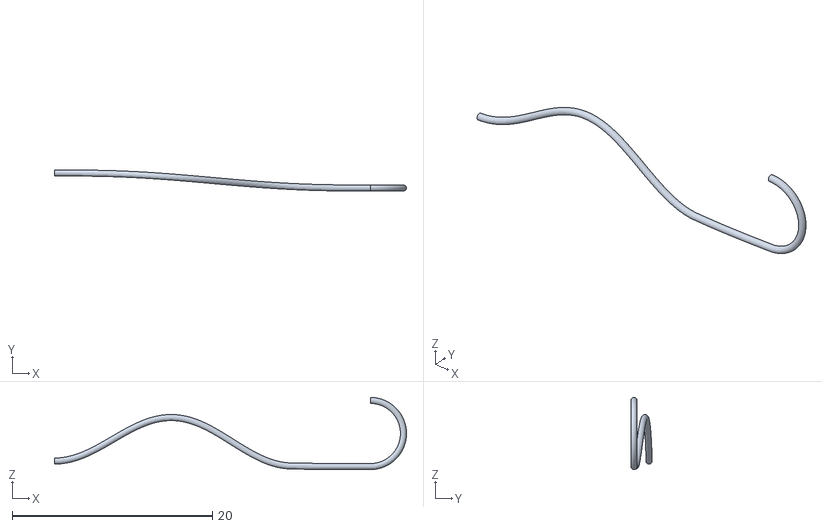
[picture p49: CAD file, 2026-11-09]
mechanical/cad/lcd-wire-bl.obj
35.1 x 2.11 x 7.21
