rushabhcodes/desk-fidget-counter/mechanical/cad/lcd-wire-clk.obj

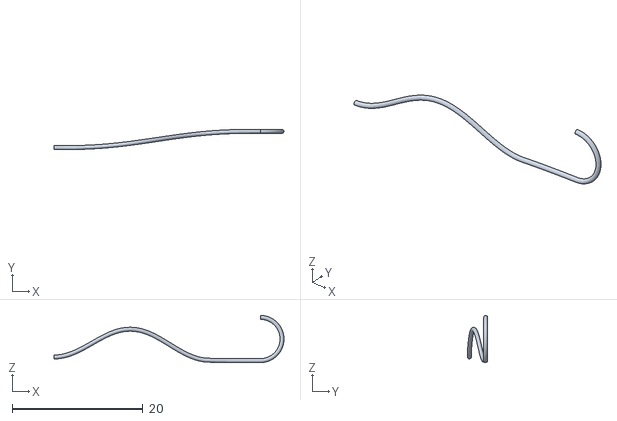
[picture p50: CAD file, 2026-11-09]
mechanical/cad/lcd-wire-clk.obj
35.1 x 3.11 x 7.21
