rushabhcodes/desk-fidget-counter/manufacturing/current/enclosure/stl/screen-bezel.stl

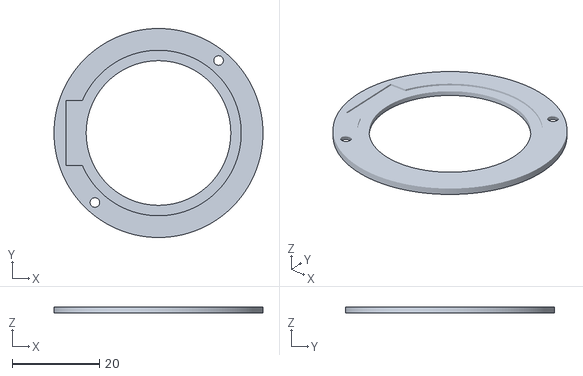
[picture p51: CAD file, 2026-11-09]
manufacturing/current/enclosure/stl/screen-bezel.stl
48.0 x 48.0 x 1.40
