rushabhcodes/desk-fidget-counter/mechanical/cad/lcd-wire-din.obj

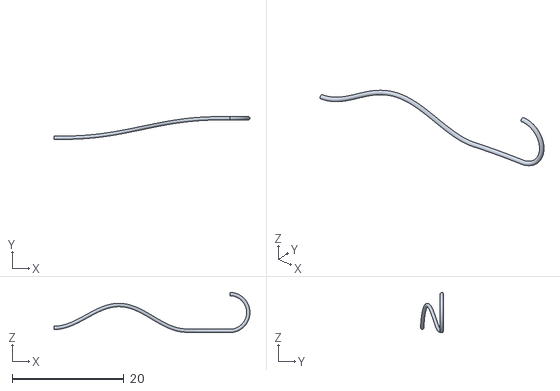
[picture p52: CAD file, 2026-11-09]
mechanical/cad/lcd-wire-din.obj
35.1 x 4.11 x 7.21
