rushabhcodes/desk-fidget-counter/manufacturing/current/enclosure/stl/fit-coupon-tight.stl

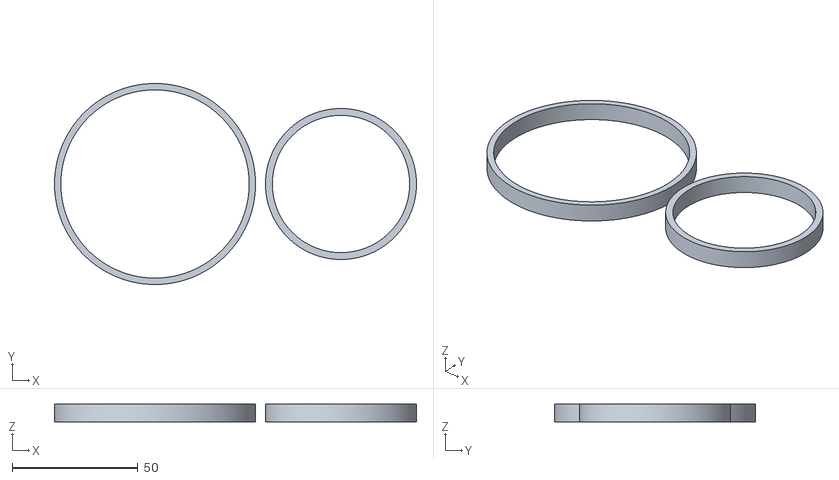
[picture p53: CAD file, 2026-11-09]
manufacturing/current/enclosure/stl/fit-coupon-tight.stl
144.1 x 80.0 x 7.00
