rushabhcodes/desk-fidget-counter/mechanical/cad/lcd-wire-gnd.obj

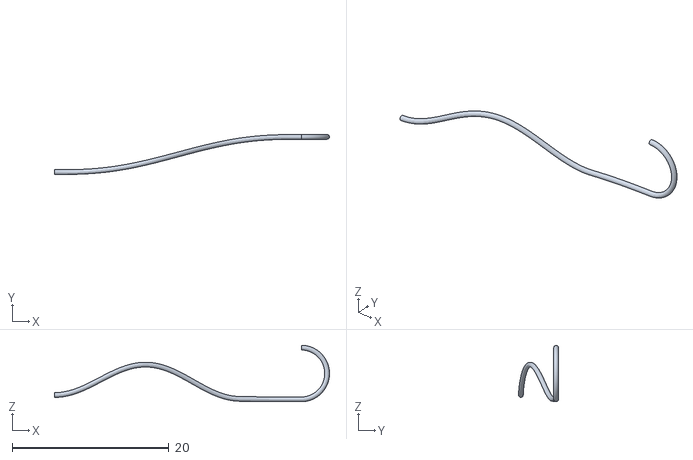
[picture p54: CAD file, 2026-11-09]
mechanical/cad/lcd-wire-gnd.obj
35.1 x 5.11 x 7.21
