rushabhcodes/desk-fidget-counter/manufacturing/current/enclosure/stl/fit-coupon-loose.stl

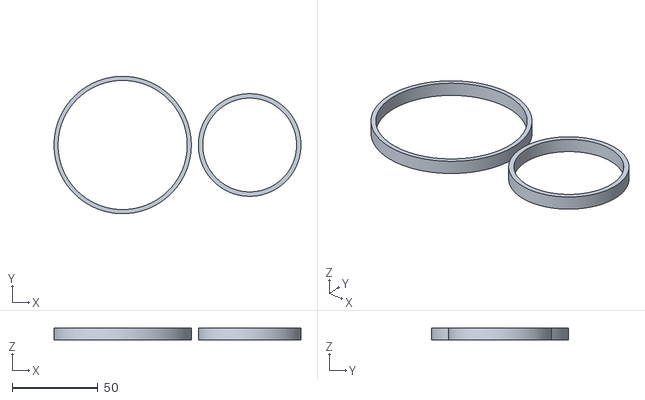
[picture p55: CAD file, 2026-11-09]
manufacturing/current/enclosure/stl/fit-coupon-loose.stl
143.9 x 80.0 x 7.00
