rushabhcodes/desk-fidget-counter/mechanical/cad/lcd-wire-rst.obj

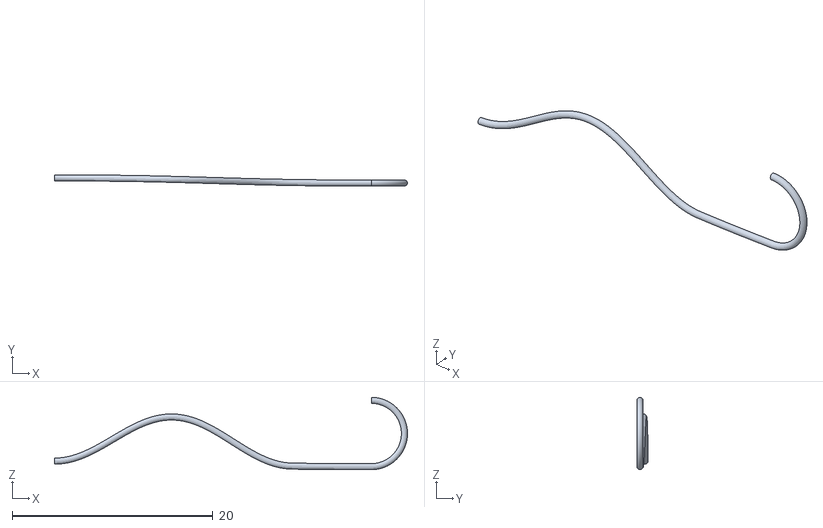
[picture p56: CAD file, 2026-11-09]
mechanical/cad/lcd-wire-rst.obj
35.1 x 1.11 x 7.21
