rushabhcodes/desk-fidget-counter/manufacturing/current/enclosure/stl/fit-coupon.stl

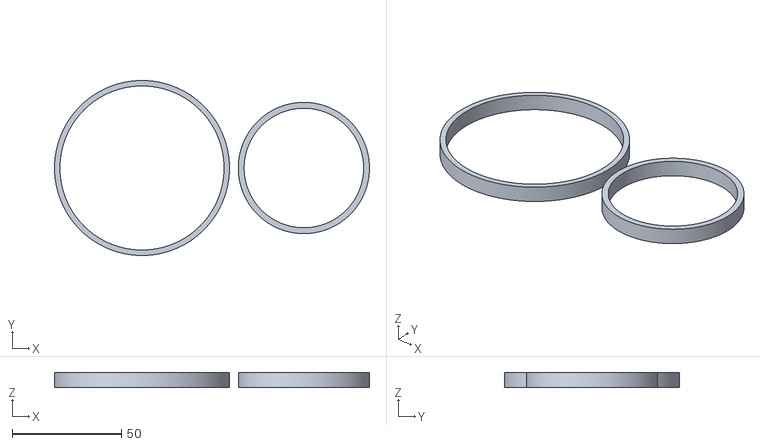
[picture p57: CAD file, 2026-11-09]
manufacturing/current/enclosure/stl/fit-coupon.stl
144.0 x 80.0 x 7.00
