rushabhcodes/desk-fidget-counter/mechanical/cad/lcd-cable-screen-plug.obj

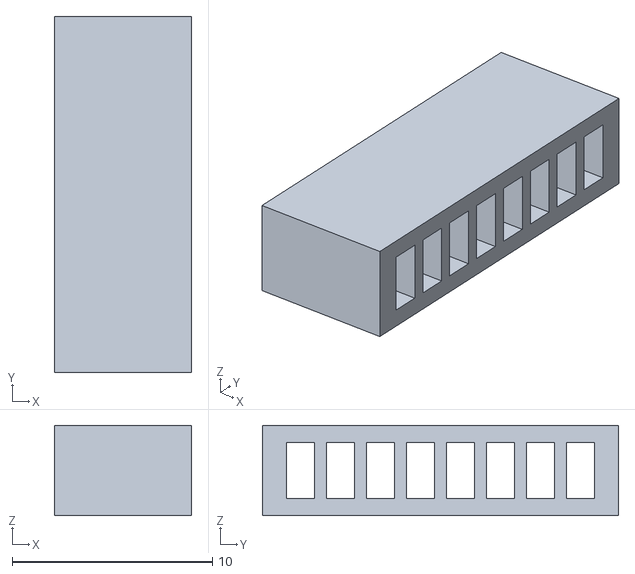
[picture p58: CAD file, 2026-11-09]
mechanical/cad/lcd-cable-screen-plug.obj
6.85 x 17.8 x 4.50
