rushabhcodes/desk-fidget-counter/mechanical/cad/lcd-cable-board-sh-plug.obj

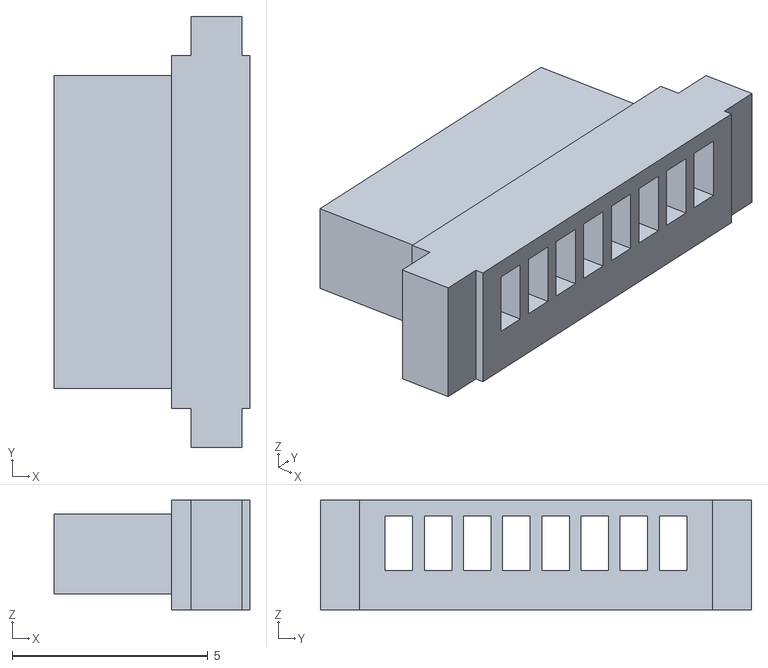
[picture p59: CAD file, 2026-11-09]
mechanical/cad/lcd-cable-board-sh-plug.obj
5.00 x 11.0 x 2.80
