rushabhcodes/desk-fidget-counter/mechanical/cad/lcd-wire-vcc.obj

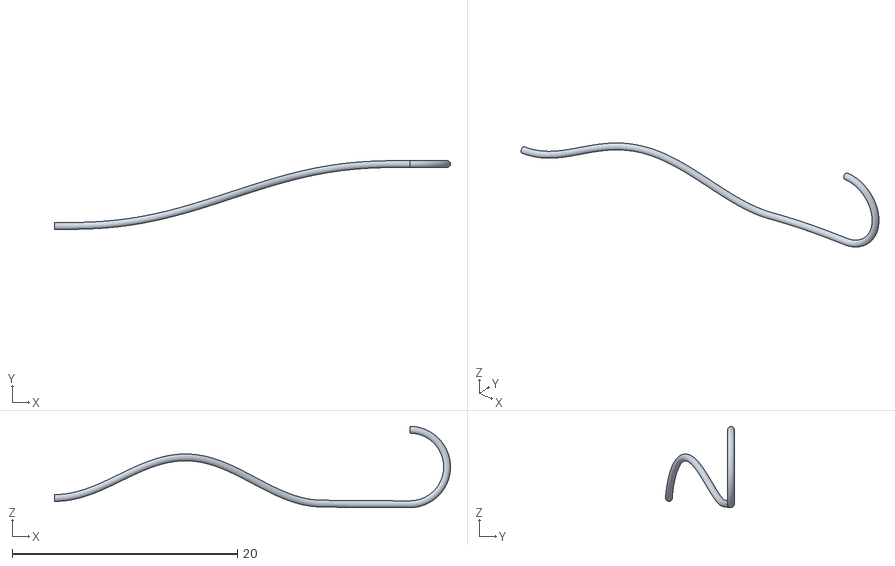
[picture p60: CAD file, 2026-11-09]
mechanical/cad/lcd-wire-vcc.obj
35.1 x 6.11 x 7.21
