rushabhcodes/desk-fidget-counter/mechanical/cad/screen-ui.obj

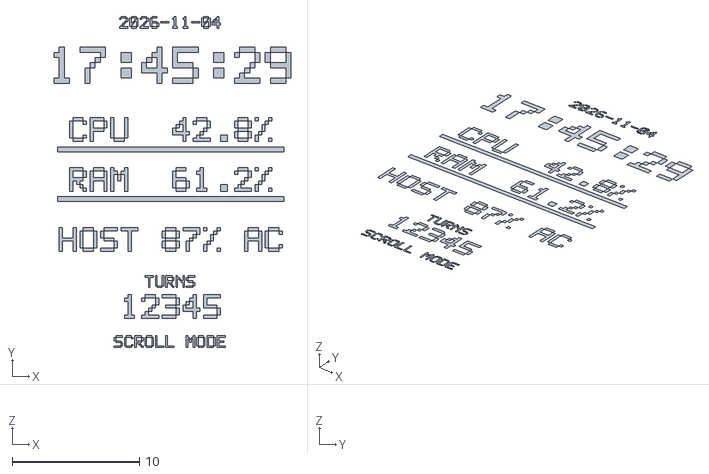
[picture p61: CAD file, 2026-11-09]
mechanical/cad/screen-ui.obj
18.6 x 26.1 x 0
