rushabhcodes/desk-fidget-counter/mechanical/cad/bearing.obj

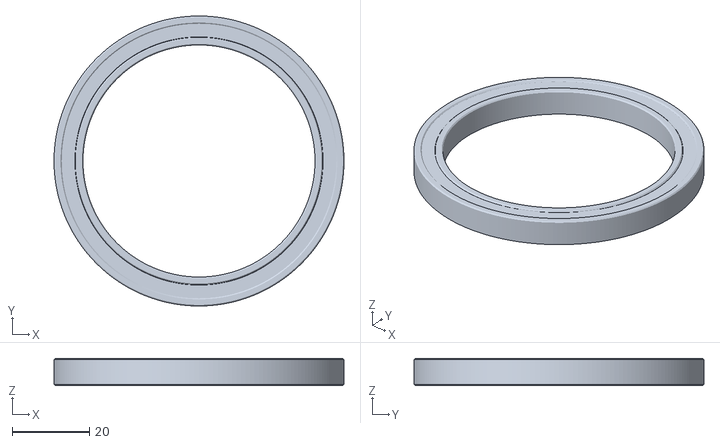
[picture p62: CAD file, 2026-11-09]
mechanical/cad/bearing.obj
75.0 x 75.0 x 7.00
