rushabhcodes/desk-fidget-counter/mechanical/cad/screen-module.obj

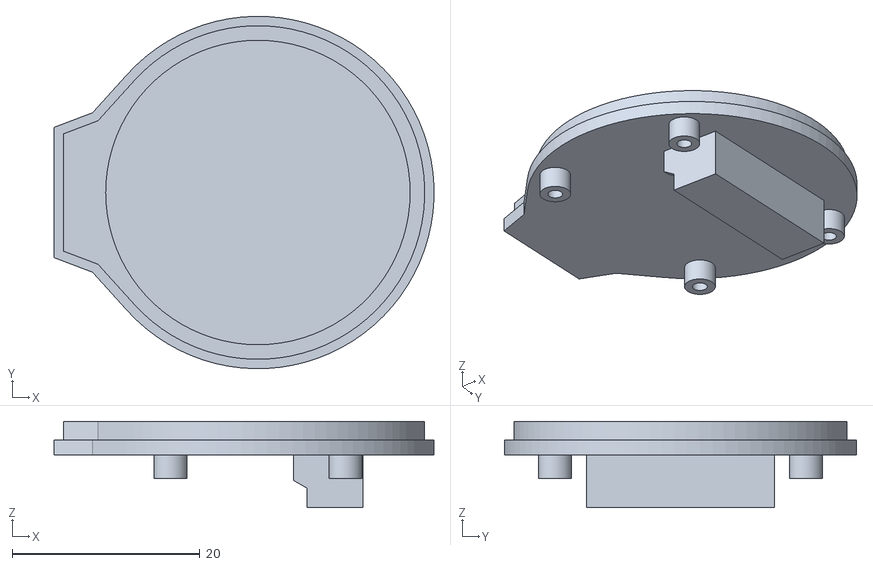
[picture p63: CAD file, 2026-11-09]
mechanical/cad/screen-module.obj
40.4 x 37.5 x 9.20
