rushabhcodes/desk-fidget-counter/mechanical/cad/fasteners.obj

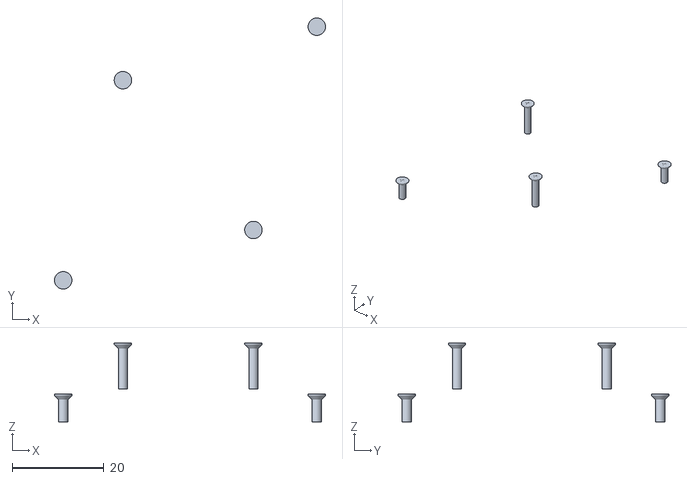
[picture p64: CAD file, 2026-11-09]
mechanical/cad/fasteners.obj
59.0 x 59.0 x 17.1
