rushabhcodes/desk-fidget-counter/mechanical/cad/pcb-pad-adhesive.obj

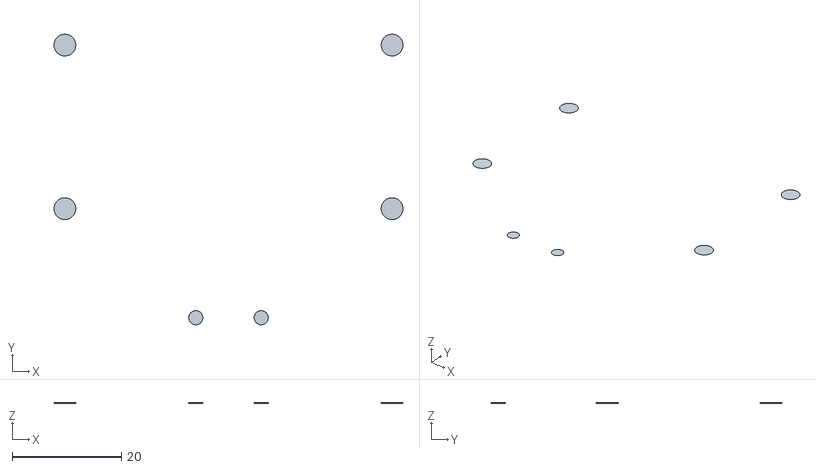
[picture p65: CAD file, 2026-11-09]
mechanical/cad/pcb-pad-adhesive.obj
64.0 x 53.3 x 0.05
