rushabhcodes/desk-fidget-counter/mechanical/cad/pcb-capture-pads.obj

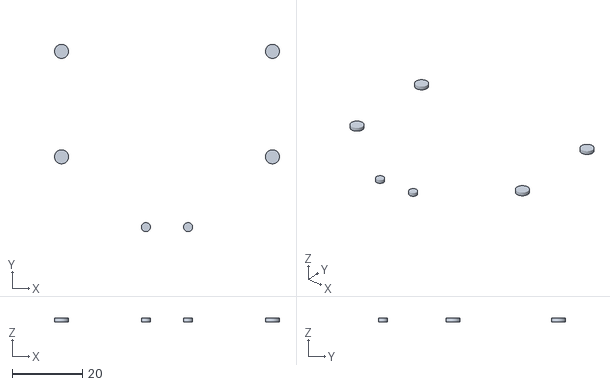
[picture p66: CAD file, 2026-11-09]
mechanical/cad/pcb-capture-pads.obj
64.0 x 53.3 x 1.05
