rushabhcodes/desk-fidget-counter/(list of files, cad)

Other CAD files:
mechanical/cad/lcd-wire-cs.obj
mechanical/cad/lcd-wire-dc.obj
mechanical/cad/screen-bezel.obj
imports/jlc/A_61300821021/A_61300821021.obj
imports/jlc/SM08B_SRSS_TB_LF__SN_/SM08B_SRSS_TB_LF__SN_.obj
imports/jlc/TYPEC_309_ACP16L65/TYPEC_309_ACP16L65.obj
mechanical/cad/base.obj
mechanical/cad/button-cap.obj
mechanical/cad/knob.obj
mechanical/cad/lid.obj
mechanical/cad/screen-carrier.obj
