rushabhcodes/desk-fidget-counter/__snapshots__/assembly.circuit-3d.snap.png

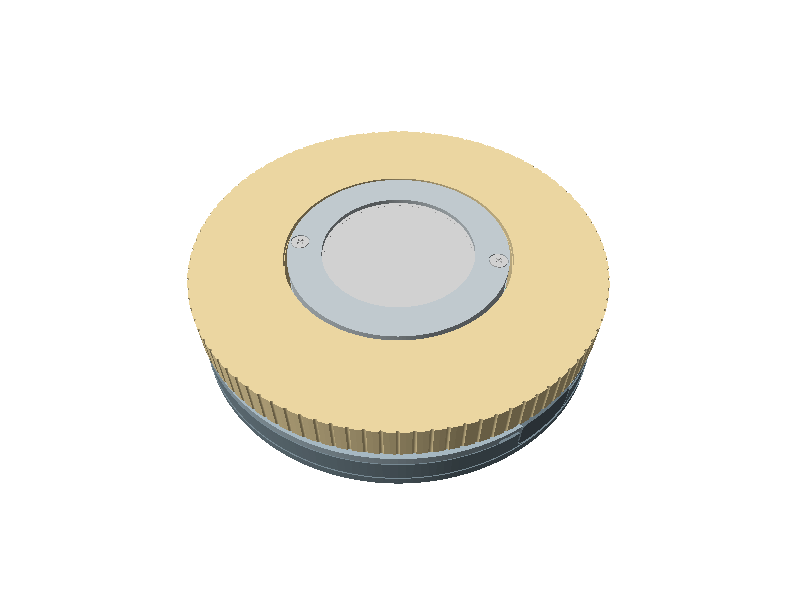
__snapshots__/assembly.circuit-3d.snap.png
