rushabhcodes/desk-fidget-counter/mechanical/wiring-cutaway.png

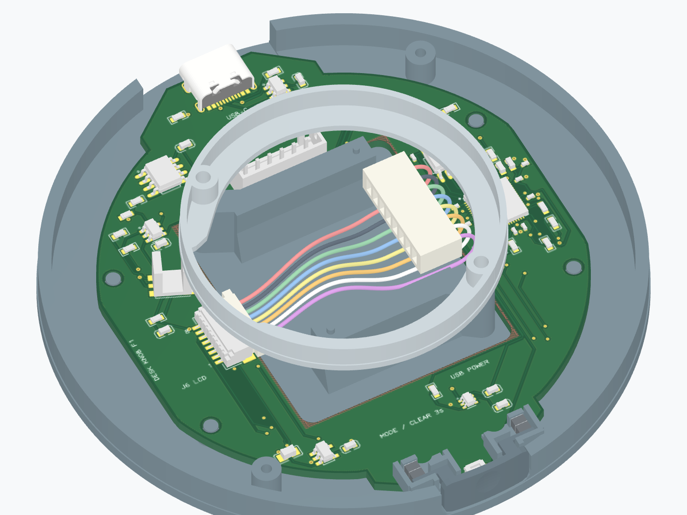
mechanical/wiring-cutaway.png
