rushabhcodes/desk-fidget-counter/previews/assembly-bottom.png

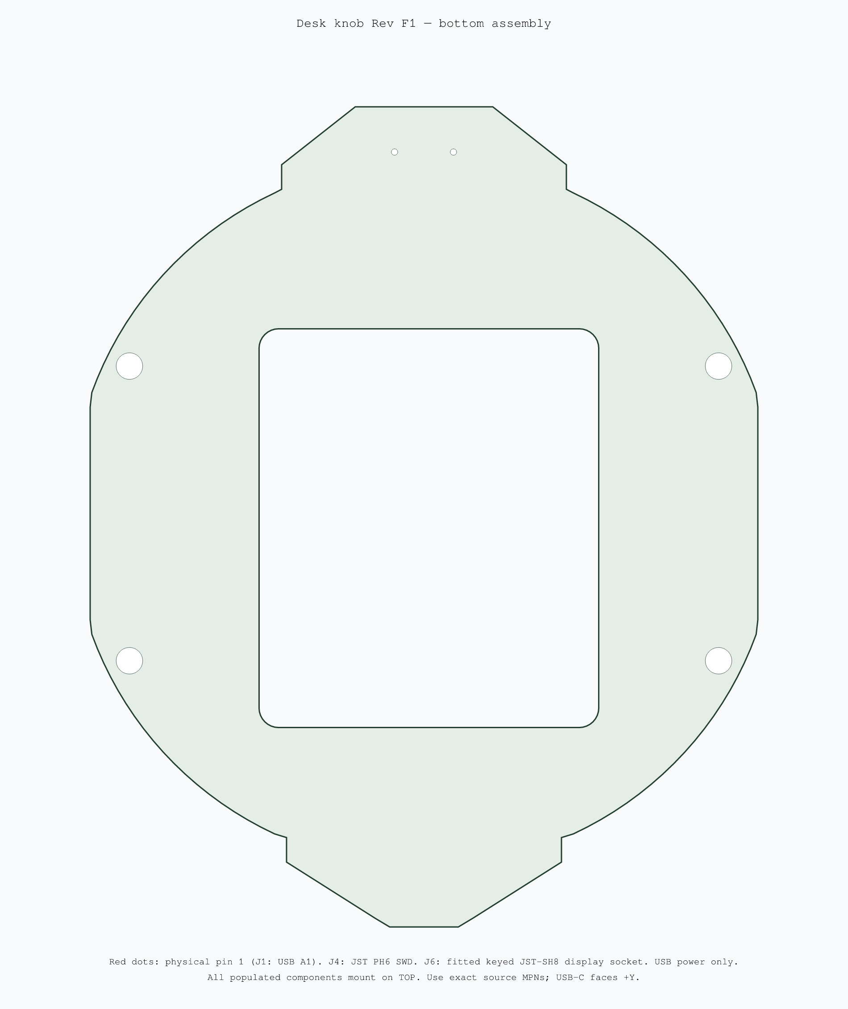
previews/assembly-bottom.png
