rushabhcodes/desk-fidget-counter/previews/wiring.png

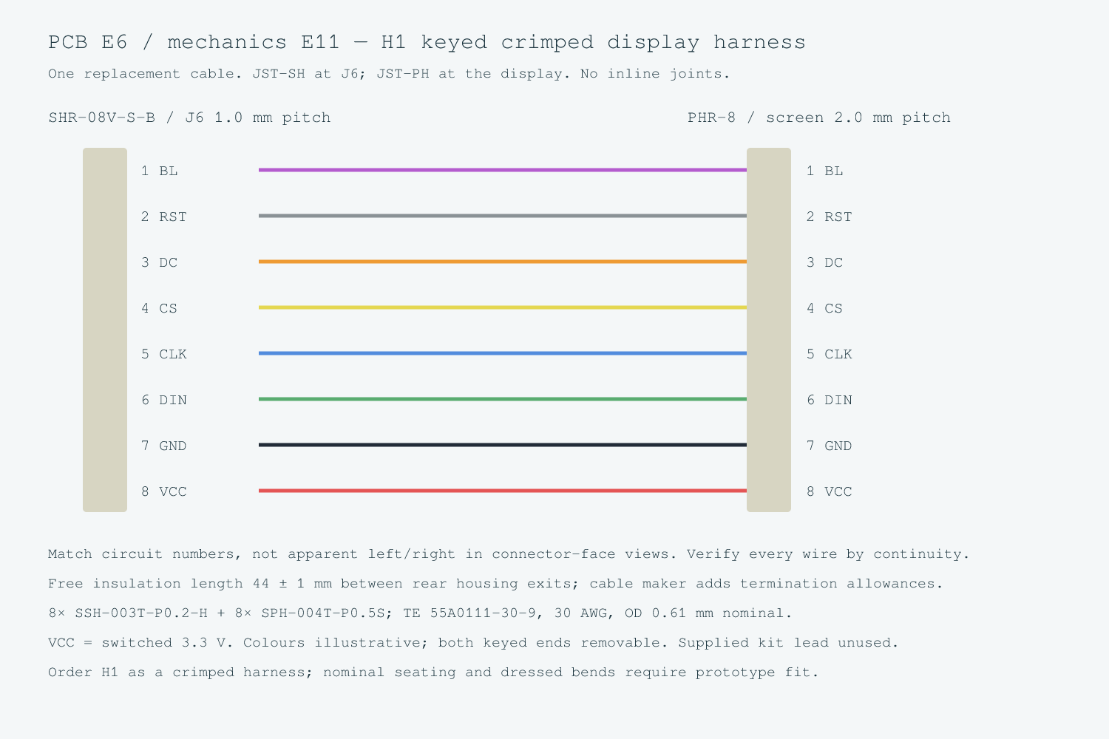
previews/wiring.png
