rushabhcodes/desk-fidget-counter/manufacturing/current/cad/desk-knob-revf1.kicad_pcb

## KiCad design manufacturing/current/cad/desk-knob-revf1.kicad_pcb (2026-11-10)

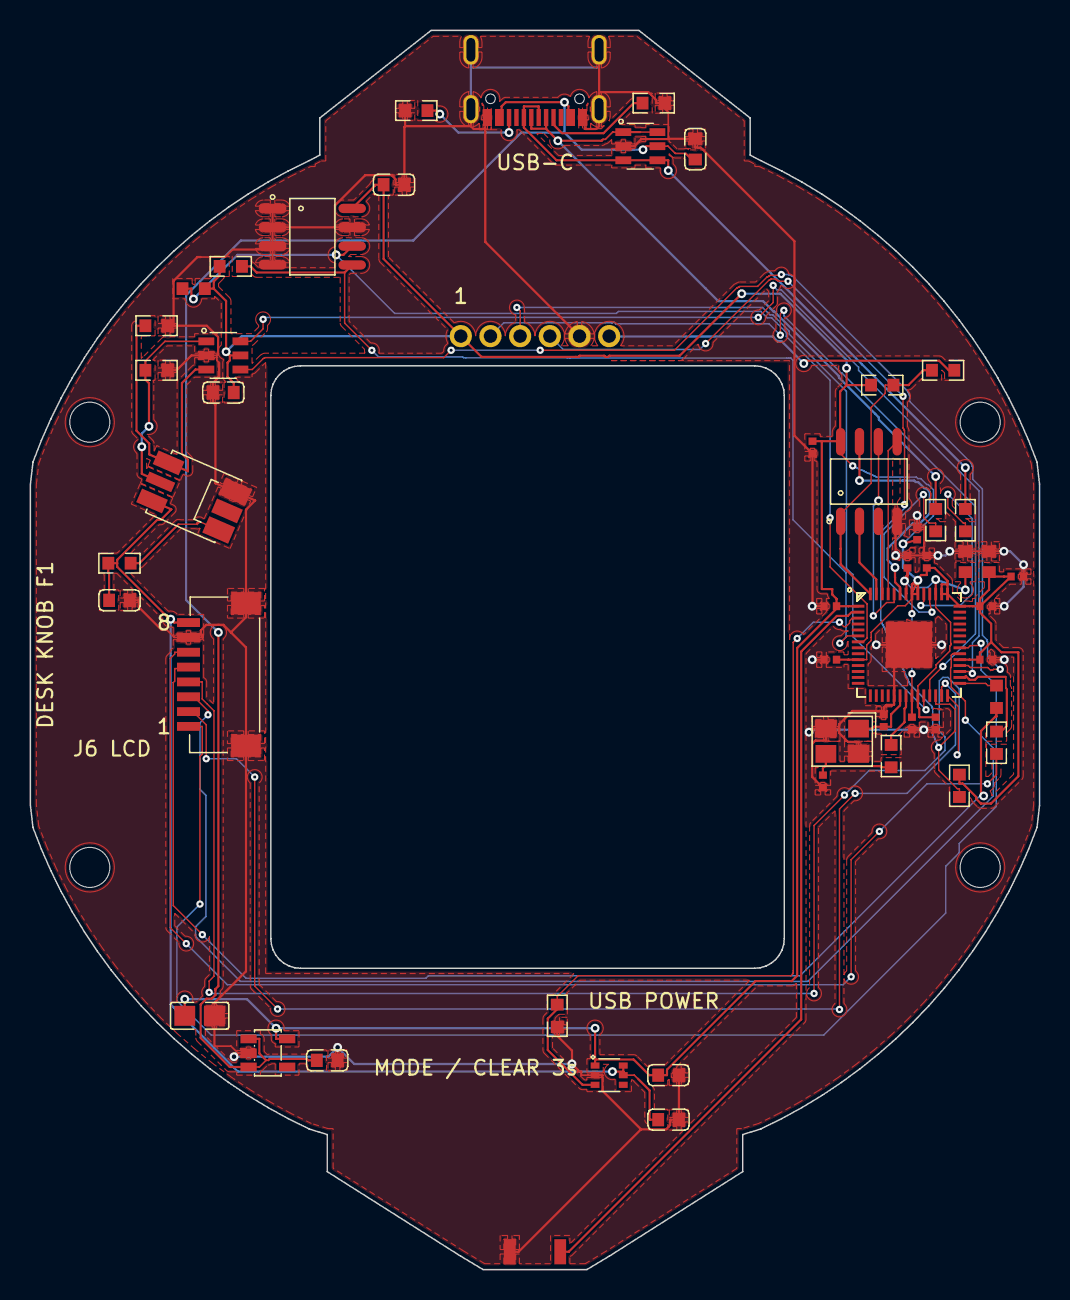
[picture p73: board desk-knob-revf1.kicad_pcb from above]

Board: 2 copper layers, 68.0 x 83.5 mm, 52 parts (0 on the bottom side), 41 nets.

Parts:
C1: 100nF; GRM188R71C104KA01D__C1
C2: 1uF; GRM188R61A105KA61D__C2
C3: 1uF; GRM188R61A105KA61D__C3
C5: 1uF; GRM188R61A105KA61D__C5
C6: 4.7uF; CL21A475KOFNNNE__C6
C7: 100nF; GRM155R71C104KA88D__C7
C8: 100nF; GRM155R71C104KA88D__C8
C9: 100nF; GRM155R71C104KA88D__C9
C10: 100nF; GRM155R71C104KA88D__C10
C11: 100nF; GRM155R71C104KA88D__C11
C12: 100nF; GRM155R71C104KA88D__C12
C13: 100nF; GRM155R71C104KA88D__C13
C14: 100nF; GRM188R71C104KA01D__C14
C15: 1uF; GRM188R61A105KA61D__C15
C16: 100nF; GRM188R71C104KA01D__C16
C17: 100nF; GRM155R71C104KA88D__C17
C18: 100nF; GRM155R71C104KA88D__C18
C19: 100nF; GRM155R71C104KA88D__C19
C20: 1uF; GRM188R61A105KA61D__C20
C21: 1uF; GRM188R61A105KA61D__C21
C22: 100nF; GRM155R71C104KA88D__C22
C23: 15pF; 0402CG150J500NT__C23
C24: 15pF; 0402CG150J500NT__C24
J1: J1; TYPEC-309-ACP16L65__J1
J4: J4; B6B-PH-K-S_LF_SN__J4
J6: J6; SM08B-SRSS-TB_LF_SN__J6
R1: 5.1kΩ; RC0603FR-075K1L__R1
R2: 5.1kΩ; RC0603FR-075K1L__R2
R3: 27Ω; 0603WAF270JT5E__R3
R4: 27Ω; 0603WAF270JT5E__R4
R5: 1kΩ; 0603WAF1001T5E__R5
R6: 1kΩ; 0603WAF1001T5E__R6
R7: 10kΩ; RC0603FR-0710KL__R7
R10: 10kΩ; RC0603FR-0710KL__R10
R12: 4.7kΩ; RC0603FR-074K7L__R12
R13: 4.7kΩ; RC0603FR-074K7L__R13
R21: 100kΩ; RC0603FR-07100KL__R21
R24: 150Ω; RC0603FR-07150RL__R24
R25: 22kΩ; RC0603FR-0722KL__R25
R26: 22kΩ; RC0603FR-0722KL__R26
R27: 22Ω; RC0603FR-0722RL__R27
R28: 22Ω; RC0603FR-0722RL__R28
SW1: SW1; B3U-3000P__SW1
U1: RP2040; RP2040__U1
U2: TCUT1600X01; TCUT1600X01__U2
U3: MB85RC256VPNF-G-AMERE2; MB85RC256VPNF-G-AMERE2__U3
U4: TPS22919DCKR; TPS22919DCKR__U4
U5: TLV75533PDBVR; TLV75533PDBVR__U5
U6: USBLC6-2SC6; USBLC6-2SC6__U6
U7: SN74LVC2G17DBVR; SN74LVC2G17DBVR__U7
U8: W25Q16JVSNIQ; W25Q16JVSNIQ__U8
X1: X1; ABM8-272-T3__X1

Connections:
BOOTSEL: J4.6, R6.2
CC1: J1.39, R1.1
CC2: J1.33, R2.1
ENC_A: U1.31, U7.6
ENC_B: U1.32, U7.4
GND: C1.2, C2.2, C3.2, C5.2, C6.2, C7.2, C8.2, C9.2, C10.2, C11.2, C12.2, C13.2, C14.2, C15.2, C16.2, C17.2, C18.2, C19.2, C20.2, C21.2, C22.2, C23.2, C24.2, J1.25, J1.26, J1.27, J1.28, J1.29, J1.30, J1.43, J1.44, J4.5, J6.7, J6.9, J6.10, R1.2, R2.2, R21.2, R25.2, R26.2, SW1.2, U1.19, U1.57, U2.3, U3.1, U3.2, U3.3, U3.4, U3.7, U4.2, U5.2, U6.2, U7.2, U8.4, X1.2, X1.4
IR_A: R24.2, U2.1
LCD_BL: J6.1, U1.35
LCD_CS: J6.4, U1.28
LCD_DC: J6.3, U1.34
LCD_MOSI: J6.6, R28.2
LCD_RST: J6.2, U1.27
LCD_SCK: J6.5, R27.2
MODE_BTN: SW1.1, U1.2
OPT_A: R25.1, U2.5, U7.1
OPT_B: R26.1, U2.4, U7.3
PERIPH_3V3: C3.1, C15.1, J6.8, R24.1, U2.6, U4.5, U4.6
PERIPH_EN: R21.1, U1.3, U4.3
QSPI_SCLK: U1.52, U8.6
QSPI_SD0: U1.53, U8.5
QSPI_SD1: U1.55, U8.2
QSPI_SD2: U1.54, U8.3
QSPI_SD3: U1.51, U8.7
QSPI_SS: R6.1, R7.1, U1.56, U8.1
RUN: J4.4, R10.1, U1.26
SCL: R13.2, U1.7, U3.6
SDA: R12.2, U1.6, U3.5
SPI_MOSI: R28.1, U1.30
SPI_SCK: R27.1, U1.29
SWCLK: J4.3, U1.24
SWDIO: J4.2, U1.25
USB_DM: J1.36, J1.38, R3.2, U6.1, U6.6
USB_DM_MCU: R3.1, U1.46
USB_DP: J1.35, J1.37, R4.2, U6.3, U6.4
USB_DP_MCU: R4.1, U1.47
V1V1: C18.1, C19.1, C21.1, U1.23, U1.45, U1.50
V3V3: C2.1, C6.1, C7.1, C8.1, C9.1, C10.1, C11.1, C12.1, C13.1, C14.1, C16.1, C17.1, C20.1, C22.1, J4.1, R7.2, R10.2, R12.1, R13.1, U1.1, U1.10, U1.22, U1.33, U1.42, U1.43, U1.44, U1.48, U1.49, U3.8, U4.1, U5.5, U7.5, U8.8
VBUS: C1.1, C5.1, J1.31, J1.32, J1.41, J1.42, U5.1, U5.3, U6.5
XIN: C23.1, U1.20, X1.1
XOUT: R5.1, U1.21
XTAL_OUT: C24.1, R5.2, X1.3
