rushabhcodes/desk-fidget-counter/firmware/tusb_config.h

// SPDX-License-Identifier: MIT
#pragma once
#include "pico.h"
#define CFG_TUSB_MCU OPT_MCU_RP2040
#ifndef CFG_TUSB_OS
#define CFG_TUSB_OS OPT_OS_PICO
#endif
#define CFG_TUSB_RHPORT0_MODE (OPT_MODE_DEVICE | OPT_MODE_FULL_SPEED)
#define CFG_TUD_ENABLED 1
#define CFG_TUSB_DEBUG 0
#define CFG_TUSB_MEM_ALIGN __attribute__((aligned(4)))
#define CFG_TUD_ENDPOINT0_SIZE 64
#define CFG_TUD_CDC 1
#define CFG_TUD_HID 1
#define CFG_TUD_CDC_NOTIFY 1
#define CFG_TUD_CDC_RX_BUFSIZE 128
#define CFG_TUD_CDC_TX_BUFSIZE 512
#define CFG_TUD_CDC_EP_BUFSIZE 64
#define CFG_TUD_HID_EP_BUFSIZE 16
