rushabhcodes/desk-fidget-counter/(commit log)

2026-11-03 Release rechargeable USB scroll knob and persistent rotation counter
    [BOM.csv, base.stl, button-plunger.stl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]
2026-11-03 Make 64-bit USB count formatting portable across ARM toolchains
2026-11-04 Add assembled product CAD, exploded models and assembly guide links
    [base.obj, battery-socket.obj, battery.obj, bearing.obj, button-plunger.obj, charger-package.obj, fasteners.obj, inner-retainer.obj]
2026-11-04 Add fixed round LCD, optical scroll ring and JST programming for Rev B
    [BOM.csv, base.obj, base.stl, bearing.obj, button-plunger.obj, button-plunger.stl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]
2026-11-04 Build low-profile Rev C with top-side assembly and nested PCB window
    [BOM.csv, base.obj, base.stl, battery-socket.obj, battery.obj, bearing-clamp.obj, bearing-clamp.stl, bearing.obj]
2026-11-04 Normalize generated CAD and drill-map text artifacts
    [base.obj, battery-socket.obj, battery.obj, bearing-clamp.obj, bearing.obj, button-plunger.obj, charger-package.obj, display-socket.obj]
2026-11-04 Add USB-only laptop dashboard and verified component assembly
    [BOM.csv, LCD-harness.csv, base.obj, base.stl, battery-socket.obj, battery.obj, bearing-clamp.obj, bearing-clamp.stl]
2026-11-04 Route complete two-layer board with native tscircuit autorouter
    [BOM.csv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]
2026-11-04 Simplify PCB to 39 parts and add accessible front mode button
    [BOM.csv, base.obj, base.stl, button-plunger.obj, button-plunger.stl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]
2026-11-04 Bring USB-C to shell wall on native-routed PCB tab
    [base.obj, base.stl, button-plunger.obj, button-plunger.stl, desk-knob-reve.kicad_pcb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]
2026-11-05 Expose original side switch and use included display lead
    [BOM.csv, LCD-harness.csv, base.obj, base.stl, button-plunger.obj, button-plunger.stl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]
2026-11-05 Document prototype procurement and bearing fit qualification
    [fit-coupon-loose.stl, fit-coupon-tight.stl]
2026-11-06 Prepare E4 prototype mechanics with explicit fit budgets and detailed bearing
    [LCD-harness.csv, base.obj, base.stl, bearing-balls.obj, bearing-cage.obj, bearing-clamp.obj, bearing-clamp.stl, bearing-inner-race.obj]
2026-11-06 Include the regenerated wiring drawing in the tagged fabrication package
2026-11-06 Prepare JLCPCB order kit and replace obsolete bulk capacitors
    [BOM-complete.csv, BOM-smt.csv, BOM.csv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]
2026-11-06 Validate exact JLCPCB footprints and native two-layer routing
    Keep the complete top-side assembly and included CAD assets, remove obsolete v5.4 manufacturing exports, and record passing source, copper, footprint and mechanical checks. Document the pending JLCPCB review of USB shield slots before fabrication.
    [BOM-complete.csv, BOM-smt.csv, BOM.csv, base.obj, base.stl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]
2026-11-07 Simplify enclosure and add a captive printed mode button
    [base.obj, base.stl, bearing-balls.obj, bearing-cage.obj, bearing-clamp.obj, bearing-clamp.stl, bearing-inner-race.obj, bearing-outer-race.obj]
2026-11-09 Brace PLA screen supports and recess mode-button guides
    [LCD-harness.csv, base.obj, base.stl, button-cap.obj, button-cap.stl, fit-coupon-loose.stl, fit-coupon-tight.stl, fit-coupon.stl]
2026-11-09 Lower the PLA enclosure to 19.5 mm
    [LCD-harness.csv, base.obj, base.stl, bearing.obj, fasteners.obj, knob.obj, knob.stl, lcd-cable-contacts.obj]
2026-11-09 Use a standard USB-C connector and validate PCB E4
    [TYPEC_309_ACP16L65.obj, TYPEC_309_ACP16L65.step, base.obj, base.stl, lid.obj, lid.stl]
2026-11-09 Audit CAD assembly and correct screen carrier clearances
    [screen-carrier.obj, screen-carrier.stl]
2026-11-09 Add removable display header and validate two-layer routing
    [A_61300821021.obj, A_61300821021.step, LCD-harness.csv, base.obj, base.stl, hardware.csv, lcd-cable-board-plugs.obj, lcd-cable-contacts.obj]
2026-11-09 Use keyed JST display connector and crimped low-profile harness
    [LCD-harness.csv, SM08B_SRSS_TB_LF__SN_.obj, SM08B_SRSS_TB_LF__SN_.step, base.obj, base.stl, hardware.csv, lcd-cable-board-plugs.obj, lcd-cable-board-sh-plug.obj]
2026-11-09 Refresh legacy PCB and schematic thumbnails from checked source
2026-11-09 Improve E12 side button and prepare fabrication release 5.11.0
    [BOM-complete.csv, BOM-smt.csv, LCD-harness.csv, base.obj, base.stl, button-cap.obj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]
2026-11-10 Replace STM32 with RP2040 and keep the E13 button within the circular enclosure
    [BOM-complete.csv, BOM-smt.csv, base.obj, base.stl, button-cap.obj, button-cap.stl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]
2026-11-10 Add E14 display collar and verified visual and fabrication review
    [desk-knob-revf1-B_Cu.gbl, desk-knob-revf1-B_Mask.gbs, desk-knob-revf1-B_Paste.gbp, desk-knob-revf1-B_Silkscreen.gbo, desk-knob-revf1-Edge_Cuts.gm1, desk-knob-revf1-F_Cu.gtl, desk-knob-revf1-F_Mask.gts, desk-knob-revf1-F_Paste.gtp]
2026-11-14 Add five-print Classic F1 service enclosure
